bradport02/RX8-CANbusGateway/PCBs/RX8-7/RX8-7_BOM.xlsx

Reference | Qnty | Value | Component name | Vendor | Link | Cost per item | Required | Total
C100 | 1 | 10u | AEH0608100M050R | Mouser | Mouser (https://www.mouser.co.uk/ProductDetail/KYOCERA-AVX/AEH0608100M050R?qs=MyNHzdoqoQI9jDRNumUOww%3D%3D) | 0.39 | Y | 0.39
C101,C102,C103,C110,C111,C112,C118,C120,C130,C208,C209,C211,C212,C213,C225,C227,C309,C310,C311,C312,C313,C407,C411,C500,C501,C502,C506,C509,C510,C511,C512,C515,C516,C517,C519,C600,C602,C604,C605,C606,C703,C704,C705,C706,C707,C708 | 46 | 100n | 06035C104K4T2A | Mouser | Mouser (https://www.mouser.co.uk/ProductDetail/KYOCERA-AVX/06035C104K4T2A?qs=46Fswce4YXm2eEM3XUkmsQ%3D%3D) | 0.024 | Y | 1.104
C104,C117,C121,C124,C405,C408 | 6 | 10u | EEE-HC1C100R | Mouser | Mouser (https://www.mouser.co.uk/ProductDetail/Panasonic/EEE-HC1C100R?qs=Ywefl8B65e5dk7Zi6ZTZRw%3D%3D) | 0.285 | Y | 1.71
C105 | 1 | 220u | EDT227M035A9PAA | Mouser | Mouser (https://www.mouser.co.uk/ProductDetail/KEMET/EDT227M035A9PAA?qs=E9QF1UCAUX4pNM%252BmAGR2%252Bg%3D%3D) | 0.458 | Y | 0.458
C106, C127 | 2 | 1u | RSVVS010M1UBC3001U | Mouser | Mouser (https://www.mouser.co.uk/ProductDetail/Elna/RSVVS010M1UBC3001U?qs=4ASt3YYao0XVkuo7v80YiA%3D%3D) | 0.292 | Y | 0.584
C108,C109,C503,C518,C107,C115, C406 | 7 | 10u | 0603DD106MAT2A | Mouser | Mouser (https://www.mouser.co.uk/ProductDetail/KYOCERA-AVX/0603DD106MAT2A?qs=tlsG%2FOw5FFj9d7E8womxdg%3D%3D) | 0.223 | Y | 1.561
C113 | 1 | 22n | C0603C223J1RECAUTO | Mouser | Mouser (https://www.mouser.co.uk/ProductDetail/KEMET/C0603C223J1RECAUTO) | 0.165 | Y | 0.165
C114 | 1 | 100u | EDT107M050A9PAA | Mouser | Mouser (https://www.mouser.co.uk/ProductDetail/KEMET/EDT107M050A9PAA?qs=E9QF1UCAUX41fhlT8nGb9A%3D%3D) | 0.736 | Y | 0.736
C116,C223 | 2 | 47u | EEE-TG1V470UP | Mouser | Mouser (https://www.mouser.co.uk/ProductDetail/Panasonic/EEE-TG1V470UP?qs=aAAGLDy8P2zoL3Y76F8z7Q%3D%3D) | 0.713 | Y | 1.426
C119 | 1 | 4u7 | MBASE168BB5475KTNA18 | Mouser | Mouser (https://www.mouser.co.uk/ProductDetail/TAIYO-YUDEN/MBASE168BB5475KTNA18) | 0.285 | Y | 0.285
C122,C123 | 2 | 47u | GRM188R60J476ME01J | Mouser | Mouser (https://www.mouser.co.uk/ProductDetail/Murata-Electronics/GRM188R60J476ME01J?qs=pUKx8fyJudCHNFLdg5iCYA%3D%3D) | 0.361 | Y | 0.722
C125, C126 | 2 | 22u | GRM188D70J226ME01D | Mouser | Mouser (https://www.mouser.co.uk/ProductDetail/Murata-Electronics/GRM188D70J226ME01D) | 0.248 | Y | 0.496
C128 | 1 | 470u | EEE-FN1C471L | Mouser | Mouser (https://www.mouser.co.uk/ProductDetail/Panasonic/EEE-FN1C471L?qs=vmHwEFxEFR8QsHsuXLyd8Q%3D%3D) | 0.668 | Y | 0.668
C129,C300,C301,C302,C314 | 5 | 4u7 | EDH475M035A9BAA | Mouser | Mouser (https://www.mouser.co.uk/ProductDetail/KEMET/EDH475M035A9BAA?qs=E9QF1UCAUX6vP1%252BGIzmYew%3D%3D) | 0.24 | Y | 1.2
C200,C201,C202,C203,C204,C205,C206,C207,C214,C220,C221,C601,C603 | 13 | 1u | C0805C105M4RACAUTO | Mouser | Mouser (https://www.mouser.co.uk/ProductDetail/KEMET/C0805C105M4RACAUTO?qs=zDkSFN9STR%2FQblumrygq6Q%3D%3D) | 0.094 | Y | 1.222
C210,C226 | 2 | 470n | C0603C474K4PACTM | Mouser | Mouser (https://www.mouser.co.uk/ProductDetail/KEMET/C0603C474K4PACTM) | 0.12 | Y | 0.24
C215,C216,C217,C218,C409,C410,C412,C413,C507,C508 | 10 | 2u2 | MCASL21GSB7225KTNA1J | Mouser | Mouser (https://www.mouser.co.uk/ProductDetail/TAIYO-YUDEN/MCASL21GSB7225KTNA1J?qs=tlsG%2FOw5FFguOmt6f5zPzQ%3D%3D) | 0.084 | Y | 0.84
C219,C607 | 2 | 10u | KGM21AR51C106MU | Mouser | Mouser (https://www.mouser.co.uk/ProductDetail/KYOCERA-AVX/KGM21AR51C106MU?qs=9vOqFld9vZXNtlZ6Q186bg%3D%3D) | 0.368 | Y | 0.736
C222 | 1 | 4700u | EEE-FK1E472SM | Mouser | Mouser (https://www.mouser.co.uk/ProductDetail/Panasonic/EEE-FK1E472SM?qs=BZBei1rCqCCdye13ZQ7qPQ%3D%3D) | 2.71 | Y | 2.71
C303,C304,C305,C306,C307,C308,C315,C316 | 8 | 220u | EEE-FT1C221AL | Mouser | Mouser (https://www.mouser.co.uk/ProductDetail/Panasonic/EEE-FT1C221AL?qs=vmHwEFxEFR9Pfq5G0xjCHw%3D%3D) | 0.48 | Y | 3.84
C400,C401,C701,C702 | 4 | 22p | 06033A220DAT2A | Mouser | Mouser (https://www.mouser.co.uk/ProductDetail/KYOCERA-AVX/06033A220DAT2A) | 0.278 | Y | 1.112
C402,C403,L400 | 3 | NA |  |  |  |  | Y | 0
C404 | 1 | 470p | 06033A220DAT2A | Mouser | Mouser (https://www.mouser.co.uk/ProductDetail/KYOCERA-AVX/06033A220DAT2A) | 0.278 | Y | 0.278
C504,C505 | 2 | 12p | VJ0603D120JXPAJ | Mouser | Mouser (https://www.mouser.co.uk/ProductDetail/Vishay-Vitramon/VJ0603D120JXPAJ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) | 0.255 | Y | 0.51
C513,C514 | 2 | 15p | 06035U150FAT2A | Mouser | Mouser (https://www.mouser.co.uk/ProductDetail/KYOCERA-AVX/06035U150FAT2A) | 0.338 | Y | 0.676
D100, D102 | 3 | RF05VYM1SFHTR | RF05VYM1SFHTR | Mouser | Mouser (https://www.mouser.co.uk/ProductDetail/ROHM-Semiconductor/RF05VYM1SFHTR?qs=4v%252BiZTmLVHEBI5apodawUw%3D%3D) | 0.225 | Y | 0.675
D101,D500 | 2 | SMAJ24A | SMAJ24A | Mouser | Mouser (https://www.mouser.co.uk/ProductDetail/Bourns/SMAJ24A?qs=A3H9pljuJ8RK3%2FFerHGtzA%3D%3D) | 0.165 | Y | 0.33
D103,D104,D105 | 3 | Zener_15V | 1PGSMA4744H | Mouser | Mouser (https://www.mouser.co.uk/ProductDetail/Taiwan-Semiconductor/1PGSMA4744H?qs=lc2O%252BfHJPVY6dYy4zPUhBQ%3D%3D) | 0.361 | Y | 1.083
D107,D108,D110,D111,D112,D114,D115,D200,D400,D504,D604 | 11 | LED | 599-1010-147F | Mouser | Mouser (https://www.mouser.co.uk/ProductDetail/Dialight/599-1010-147F?qs=3GbUB62Nf7eZvIrTUxTNgA%3D%3D) | 0.127 | Y | 1.397
D109 | 1 | 1.5KExxA | SA36CA-E3/54 | Mouser | Mouser (https://www.mouser.co.uk/ProductDetail/Vishay-General-Semiconductor/SA36CA-E3-54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) | 0.413 | Y | 0.413
D401 | 1 | NUP2105L | NUP2105L | Mouser | Mouser (https://www.mouser.co.uk/ProductDetail/Diotec-Semiconductor/NUP2105L?qs=OlC7AqGiEDnwfsnn7%252BuLZg%3D%3D) | 0.271 | Y | 0.271
D501 | 1 | BAT54W | BAT54W | Mouser | Mouser (https://www.mouser.co.uk/ProductDetail/Diotec-Semiconductor/BAT54W?qs=OlC7AqGiEDlMBXEhja5nBg%3D%3D) | 0.135 | Y | 0.135
D502,D503,D600,D601,D602 | 5 | ESD9B5.0ST5G | ESD9B5.0ST5G | Mouser | Mouser (https://www.mouser.co.uk/ProductDetail/onsemi/ESD9B5.0ST5G?qs=HL4IEvuNMQqfrGPZiLZXfQ%3D%3D) | 0.075 | Y | 0.375
D505 | 1 | SS14 | SS14 | Mouser | Mouser (https://www.mouser.co.uk/ProductDetail/Taiwan-Semiconductor/SS14?qs=JV7lzlMm3yLIdi0ESVd3YQ%3D%3D) | 0.173 | Y | 0.173
D603 | 1 | WS2812B | WS2812B | Mouser | Mouser | 0.6 | Y | 0.6
D700,D701 | 2 | ESD2CAN24DBZRQ1 | ESD2CAN24DBZRQ1 | Mouser | Mouser (https://www.mouser.co.uk/ProductDetail/Texas-Instruments/ESD2CAN24DBZRQ1?qs=Y0Uzf4wQF3knJz9mU6BNuw%3D%3D) | 0.54 | Y | 1.08
FB100 | 1 | FerriteBead | ABPY00160808121Y00 | Mouser | Mouser (https://www.mouser.co.uk/ProductDetail/Pulse-Electronics/ABPY00160808121Y00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) | 0.083 | Y | 0.083
FB400 | 1 | FerriteBead | NA |  |  | 0 | Y | 0
FB500 | 1 | FerriteBead | BLM18RK102SN1D | Mouser | Mouser (https://www.mouser.co.uk/ProductDetail/Murata-Electronics/BLM18RK102SN1D?qs=%252BZb2rAcz85rrD89adt6lAQ%3D%3D) | 0.075 | Y | 0.075
J100,J502,J601 | 3 | USB_C_Receptacle_USB2.0_16P | UJ20-C-H-G-SMT-2A-P16-TR | Mouser | Mouser (https://www.mouser.co.uk/ProductDetail/Same-Sky/UJ20-C-H-G-SMT-2A-P16-TR?qs=6avfeC6zeS4lRZlgHZHlwQ%3D%3D) | 0.361 | Y | 1.083
J401 | 1 | Audio Jack | 35RASMT6CHNTRX | Mouser | Mouser (https://www.mouser.co.uk/ProductDetail/Switchcraft/35RASMT6CHNTRX?qs=tlsG%2FOw5FFjAOUhC8CJiRQ%3D%3D) | 1.86 | Y | 1.86
J600 | 1 | Conn_01x28_Pin | PHDR-28VS | Mouser | Mouser (https://www.mouser.co.uk/ProductDetail/JST-Commercial/PHDR-28VS?qs=QpmGXVUTftGCZ07TNYaQpw%3D%3D) | 0.353 | Y | 0.353
J800 | 1 | 34958-0383 | 34958-0383 | Mouser | Mouser (https://www.mouser.co.uk/ProductDetail/Molex/34958-0383?qs=Zz7%252BYVVL6bGxJEg%252BS51b4A%3D%3D) | 1.98 | Y | 1.98
J800 [MALE] | 1 | 34959-0390 | 34959-0390 | Mouser | Mouser (https://www.mouser.co.uk/ProductDetail/Molex/34959-0390?qs=Zz7%252BYVVL6bFXGwaF6xpqsw%3D%3D) | 1.9 | Y | 1.9
J802 | 1 | Fakra | 2FA1-NCSP-PCBB6 | Mouser | Mouser (https://www.mouser.co.uk/ProductDetail/Amphenol-RF/2FA1-NCSP-PCBB6?qs=hWgE7mdIu5RJuEY7QFoJaQ%3D%3D) | 2.43 | Y | 2.43
L100 | 1 | 4.7uH | XAL7030-472MEC | Mouser | Mouser (https://www.mouser.co.uk/ProductDetail/Coilcraft/XAL7030-472MEC?qs=zCSbvcPd3paDmbzDaM4bvA%3D%3D) | 1.9 | Y | 1.9
L200,L201,L202,L203 | 4 | 10u | SRP5030HMT-100M | Mouser | Mouser (https://www.mouser.co.uk/ProductDetail/Bourns/SRP5030HMT-100M?qs=Tc%252BHE9vUsntweIXd4XNonQ%3D%3D) | 0.89 | N | 0
L401 | 1 | 10u | NLCV32T-100J-EFRD | Mouser | Mouser (https://www.mouser.co.uk/ProductDetail/TDK/NLCV32T-100J-EFRD?qs=6avfeC6zeS43g1Pl%252BxWcqA%3D%3D) | 0.21 | Y | 0.21
Q100,Q300,Q301,Q400,Q401,Q402,Q403,Q404,Q500,Q501,Q502,Q503,Q600,Q601,Q602 | 15 | NPN | BC817 | Mouser | Mouser (https://www.mouser.co.uk/ProductDetail/Rectron/BC817?qs=7pEAo90IqNG%2FF7QnbDH5iA%3D%3D) | 0.249 | Y | 3.735
Q101,Q102,Q103 | 3 | P-Channel Mosfet | SQJ407EP-T1_GE3 | Mouser | Mouser (https://www.mouser.co.uk/ProductDetail/Vishay-Semiconductors/SQJ407EP-T1_GE3?qs=5aG0NVq1C4xX2SBP0n1NTg%3D%3D) | 1.43 | Y | 4.29
R100,R110,R113,R205,R416,R518,R615,R109,R114,R123 | 10 | 22k | CRG0603F22K/10 | Mouser | Mouser (https://www.mouser.co.uk/ProductDetail/TE-Connectivity-Holsworthy/CRG0603F22K-10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) | 0.015 | Y | 0.15
R101,R102,R206,R207,R208,R209,R210,R211,R213,R360,R361,R400,R401,R402,R403,R404,R405,R408,R409,R413,R414,R417,R418,R419,R420,R500,R501,R502,R504,R506,R509,R510,R511,R516,R600,R601,R609,R610,R614,R702,R707,R709,R340,R341,R342,R343,R344,R345,R364,R365,R708 | 51 | 10k | 0603WAJ0103TCE | Mouser | Mouser (https://www.mouser.co.uk/ProductDetail/Royalohm/0603WAJ0103TCE) | 0.005 | Y | 0.255
R103,R104 | 2 | 2k5 | RNCF0603BTE2K50 | Mouser | Mouser (https://www.mouser.co.uk/ProductDetail/SEI-Stackpole/RNCF0603BTE2K50) | 0.075 | Y | 0.15
R105,R106 | 2 | 10k | RMCF1210JT180R | Mouser | Mouser (https://www.mouser.co.uk/ProductDetail/SEI-Stackpole/RMCF1210JT180R?qs=IPgv5n7u5QaiAbC7MQ%252BkTQ%3D%3D) | 0.09 | Y | 0.18
R107,R108,R505,R508,R604,R605 | 10 | 5k1 | AC0603FR-7W5K1L | Mouser | Mouser (https://www.mouser.co.uk/ProductDetail/YAGEO/AC0603FR-7W5K1L) | 0.019 | Y | 0.19
R111 | 1 | 62k | CR0603-JW-623ELF | Mouser | Mouser (https://www.mouser.co.uk/ProductDetail/Bourns/CR0603-JW-623ELF) | 0.075 | Y | 0.075
R112 | 1 | 51k | CR0603-JW-513ELF | Mouser | Mouser (https://www.mouser.co.uk/ProductDetail/Bourns/CR0603-JW-513ELF?qs=tknLyCMIRbODFBOq4KB%2Fuw%3D%3D) | 0.075 | Y | 0.075
R115,R204 | 2 | 100k | CR0603-JW-104ELF | Mouser | Mouser (https://www.mouser.co.uk/ProductDetail/Bourns/CR0603-JW-104ELF?qs=wOX%252BDVkMoZSK2gq9cFrtRg%3D%3D) | 0.075 | Y | 0.15
R116 | 1 | 240R | CR0603-FX-2400ELF | Mouser | Mouser (https://www.mouser.co.uk/ProductDetail/Bourns/CR0603-FX-2400ELF?qs=I4suiNu8FYBRQqwAwbm7zw%3D%3D) | 0.075 | Y | 0.075
R117 | 1 | 1k5 | CR0603-JW-152ELF | Mouser | Mouser (https://www.mouser.co.uk/ProductDetail/Bourns/CR0603-JW-152ELF?qs=wOX%252BDVkMoZSu%252BfxzrcTI6Q%3D%3D) | 0.075 | Y | 0.075
R118,R122 | 2 | 2K2 | CR0603-FX-2201ELF | Mouser | Mouser (https://www.mouser.co.uk/ProductDetail/Bourns/CR0603-FX-2201ELF?qs=zx2075yZkZKUzLkJq4yLqg%3D%3D) | 0.075 | Y | 0.15
R119 | 1 | 2k | CR0603-JW-202ELF | Mouser | Mouser (https://www.mouser.co.uk/ProductDetail/Bourns/CR0603-JW-202ELF?qs=QNvGIbmBFedJvqrSZNeMIw%3D%3D) | 0.075 | Y | 0.075
R120 | 1 | 12k | CR0603-FX-1202ELF | Mouser | Mouser (https://www.mouser.co.uk/ProductDetail/Bourns/CR0603-FX-1202ELF?qs=e7cxVwPieuqIXTNAyS26aw%3D%3D) | 0.075 | Y | 0.075
R121 | 1 | 1k8 | CR0603-FX-1801ELF | Mouser | Mouser (https://www.mouser.co.uk/ProductDetail/Bourns/CR0603-FX-1801ELF) | 0.075 | Y | 0.075
R200,R201,R202,R203 | 4 | 10R | RC0603JR-7W10RL | Mouser | Mouser (https://www.mouser.co.uk/ProductDetail/YAGEO/RC0603JR-7W10RL?qs=qpJ%252B%252B%252Bdg6p3Vm%252BWSNdcdfQ%3D%3D) | 0.075 | Y | 0.3
R212,R603 | 2 | 47k | CR0603-FX-4702ELF | Mouser | Mouser (https://www.mouser.co.uk/ProductDetail/Bourns/CR0603-FX-4702ELF?qs=CCIlxZRRv7h9SmHwXOyFMw%3D%3D) | 0.075 | Y | 0.15
R300,R301,R302,R348 | 4 | 4k3 | CR0603-JW-432ELF | Mouser | Mouser (https://www.mouser.co.uk/ProductDetail/Bourns/CR0603-JW-432ELF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) | 0.075 | Y | 0.3
R303,R304,R305,R313,R315,R321,R334,R335,R336,R337,R338,R339,R349,R353,R362,R363,R317,R318,R319,R320,R507,R520,R606,R607,R611,R612,R700,R703,R704 | 29 | 0R | CR0603AJ/-000EAS | Mouser | Mouser (https://www.mouser.co.uk/ProductDetail/Bourns/CR0603AJ-000EAS?qs=PzGy0jfpSMtRj%252B7fJP4d3A%3D%3D) | 0.013 | Y | 0.377
R306,R307,R310,R350 | 4 | 27k | CR0603-FX-2702ELF | Mouser | Mouser (https://www.mouser.co.uk/ProductDetail/Bourns/CR0603-FX-2702ELF?qs=I4suiNu8FYAlO3noFFocQg%3D%3D) | 0.075 | Y | 0.3
R308,R309,R311,R312,R314,R316,R331,R332,R333,R351,R352,R359 | 12 | 4k7 | AC0603JR-104K7L | Mouser | Mouser (https://www.mouser.co.uk/ProductDetail/YAGEO/AC0603JR-104K7L?qs=r5DSvlrkXmI4EipxgBaQVg%3D%3D) | 0.011 | Y | 0.132
R322,R323,R324,R328,R329,R330,R357,R358 | 8 | 4R7 | CRCW06034R70FKEAC | Mouser | Mouser (https://www.mouser.co.uk/ProductDetail/Vishay/CRCW06034R70FKEAC) | 0.027 | Y | 0.216
R325,R326,R327,R354. R355,R356,R406,R407,R410,R411,R412,R503,R514,R517,R608,R613 | 16 | 1k | CR0603-FX-1001EPF | Mouser | Mouser (https://www.mouser.co.uk/ProductDetail/Bourns/CR0603-FX-1001EPF) | 0.028 | Y | 0.448
R346,R347 | 2 | 3k3 | CR0603-FX-3301ELF | Mouser | Mouser (https://www.mouser.co.uk/ProductDetail/Bourns/CR0603-FX-3301ELF?qs=I4suiNu8FYAeN75YxKNWXA%3D%3D) | 0.075 | Y | 0.15
R421,R422 | 2 | 470R | RC0603FR-07470RL | Mouser | Mouser (https://www.mouser.co.uk/ProductDetail/YAGEO/RC0603FR-07470RL) | 0.075 | Y | 0.15
R512,R513 | 2 | 22R | RC0603JR-0722RL | Mouser | Mouser (https://www.mouser.co.uk/ProductDetail/YAGEO/RC0603JR-0722RL) | 0.075 | Y | 0.15
R515 | 1 | 82k | 560112116085 | Mouser | Mouser (https://www.mouser.co.uk/ProductDetail/Wurth-Elektronik/560112116085) | 0.083 | Y | 0.083
R519 | 1 | 33k | RC0603DR-0733KL | Mouser | Mouser (https://www.mouser.co.uk/ProductDetail/YAGEO/RC0603DR-0733KL) | 0.075 | Y | 0.075
R602 | 1 | 22k1 | CR0603-FX-2212ELF | Mouser | Mouser (https://www.mouser.co.uk/ProductDetail/Bourns/CR0603-FX-2212ELF) | 0.075 | Y | 0.075
R701,R705,R706 | 3 | 120R | CR0603-JW-121ELF | Mouser | Mouser (https://www.mouser.co.uk/ProductDetail/Bourns/CR0603-JW-121ELF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) | 0.075 | Y | 0.225
REG100 | 1 | TPS7B8233QDGNRQ1 | TPS7B8233QDGNRQ1 | Mouser | Mouser (https://www.mouser.co.uk/ProductDetail/Texas-Instruments/TPS7B8233QDGNRQ1?qs=gTYE2QTfZfTgserf%2FHg6KA%3D%3D) | 1.35 | Y | 1.35
REG101 | 1 | LF80_TO252 | LF80CDT-TR | Mouser | Mouser (https://www.mouser.co.uk/ProductDetail/STMicroelectronics/LF80ABDT-TR?qs=rQxjsk9FJaKqWqynhzWMLQ%3D%3D) | 0.801 | Y | 0.801
REG102 | 1 | LD1117S33TR_SOT223 | LD1117S33TR | Mouser | Mouser (https://www.mouser.co.uk/ProductDetail/STMicroelectronics/LD1117S33TR?qs=edoyzKMbmhntQZx4BFmoqw%3D%3D) | 0.255 | Y | 0.255
REG103 | 1 | MPQ4317GRE-5-AEC1-P | MPQ4317GRE-5-AEC1-P | Mouser | Mouser (https://www.mouser.co.uk/ProductDetail/Monolithic-Power-Systems-MPS/MPQ4317GRE-5-AEC1-P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) | 4.33 | Y | 4.33
REG104 | 1 | NCV1117DT33T5G | NCV1117DT33T5G | Mouser | Mouser (https://www.mouser.co.uk/ProductDetail/onsemi/NCV1117DT33T5G?qs=8sOby8ZxZLGSqIbW45S1Hw%3D%3D) | 0.45 | Y | 0.45
REG105 | 1 | NCV317MBDTRKG | NCV317MBDTRKG | Mouser | Mouser (https://www.mouser.co.uk/ProductDetail/onsemi/NCV317MBDTRKG?qs=u61i7LeC7JdMf7rjvmy4qA%3D%3D) | 0.323 | Y | 0.323
REG106 | 1 | LDO40LPURY | LDO40LPURY | Mouser | Mouser (https://www.mouser.co.uk/ProductDetail/STMicroelectronics/LDO40LPURY?qs=qSfuJ%252Bfl%2Fd6C3Fwu6g7H1A%3D%3D) | 1.89 | Y | 1.89
RN600 | 1 | R_Network04 | EXB-24V103JX | Mouser | Mouser (https://www.mouser.co.uk/ProductDetail/Panasonic/EXB-24V103JX?qs=oE3VwAv%2FYtkgg9h0ON1hVg%3D%3D) | 0.075 | Y | 0.075
SW500,SW600,SW601 | 3 | PTS636SKG25JSMTR_LFS | PTS636SKG25JSMTR LFS | Mouser | Mouser (https://www.mouser.co.uk/ProductDetail/CK/PTS636SKG25JSMTR-LFS?qs=jcD%2FCkGBYeNo6fuer6a%2Fog%3D%3D) | 0.18 | Y | 0.54
U200 | 1 | TDA7719 | TDA7719 | Mouser | Mouser (https://www.mouser.co.uk/ProductDetail/STMicroelectronics/TDA7719?qs=pW7VN3fQ%252BU8DQGKC11TzWg%3D%3D) | 2.7 | Y | 2.7
U201 | 1 | TDA7388 | TDA7388 | Mouser | Mouser (https://www.mouser.co.uk/ProductDetail/STMicroelectronics/TDA7388?qs=zDsuRuHENM8sRq8DuFBdHA%3D%3D) | 2.97 | Y | 2.97
U300,U301,U302,U303 | 4 | NJM4556A | NJM4556AM | Mouser | Mouser (https://www.mouser.co.uk/ProductDetail/Nisshinbo/NJM4556AM?qs=Dx6nUK05NTEu0NN353RDQw%3D%3D) | 0.736 | N | 0
U400 | 1 | SI4703-C19-GM | SI4703-C19-GM | Mouser | Mouser (https://www.mouser.co.uk/ProductDetail/Skyworks-Solutions-Inc/SI4703-C19-GM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) | 2.6 | Y | 2.6
U401 | 1 | PCM5102A | PCM5102APWR | Mouser | Mouser (https://www.mouser.co.uk/ProductDetail/Texas-Instruments/PCM5102APWR?qs=E2%2FxqS9xjzrfECkwEYoiyg%3D%3D) | 2.96 | Y | 2.96
U500 | 1 | MCP1402T-E_OT | MCP1402T-E/OT | Mouser | Mouser (https://www.mouser.co.uk/ProductDetail/Microchip-Technology/MCP1402T-E-OT?qs=aE5D7Pt6ky3dpBpieBLY3A%3D%3D) | 0.563 | Y | 0.563
U501 | 1 | STM32H750VBTx | STM32H750VBT | Mouser | Mouser (https://www.mouser.co.uk/ProductDetail/STMicroelectronics/STM32H750VBT6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) | 5.56 | Y | 5.56
U502 | 1 | W25Q32JVSS | W25Q32JWSSIQ | Mouser | Mouser (https://www.mouser.co.uk/ProductDetail/Winbond/W25Q32JWSSIQ?qs=qSfuJ%252Bfl%2Fd7AWkQW3HAQ%252Bw%3D%3D) | 0.826 | Y | 0.826
U503 | 1 | 74HC245 | 74HC245D-Q100J | Mouser | Mouser (https://www.mouser.co.uk/ProductDetail/Nexperia/74HC245D-Q100J?qs=fi7yB2oewZl7Ar%2FomFTdgQ%3D%3D) | 0.45 | Y | 0.45
U600 | 1 | CP2102N-Axx-xQFN28 | CP2102N-A02-GQFN28R | Mouser | Mouser (https://www.mouser.co.uk/ProductDetail/Silicon-Labs/CP2102N-A02-GQFN28R?qs=u16ybLDytRag4qKvSH3fTw%3D%3D) | 2.65 | Y | 2.65
U601 | 1 | ESP32-S3-WROOM-1 | ESP32-S3-WROOM-1-N16R8 | Mouser | Mouser (https://www.mouser.co.uk/ProductDetail/Espressif-Systems/ESP32-S3-WROOM-1-N16R8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) | 5.04 | Y | 5.04
U602 | 1 | Raspberry_Pi_5 | Raspberry Pi 5 4GB | Farnell | Farnell (https://uk.farnell.com/raspberry-pi/rpi5-4gb-single/rpi-5-board-2-4ghz-4gb-arm-cortex/dp/4255998) | 75.552 | N | 0
U700,U702,U703 | 3 | TCAN1051VDRQ1 | TCAN1051VDRQ1 | Mouser | Mouser (https://www.mouser.co.uk/ProductDetail/Texas-Instruments/TCAN1051VDRQ1?qs=dSktwyqbRaUHuzLGCY%2FY8w%3D%3D) | 1.68 | Y | 5.04
U701 | 1 | MCP2515-xSO | MCP2515T-E/SO | Mouser | Mouser (https://www.mouser.co.uk/ProductDetail/Microchip-Technology/MCP2515T-E-SO?qs=YUl711QUJY3%2FLJ5ChGwQqA%3D%3D) | 2.23 | Y | 2.23
U704,U705 | 2 | LM75B | LM75BIMMX-5/NOPB | Mouser | Mouser (https://www.mouser.co.uk/ProductDetail/Texas-Instruments/LM75BIMMX-5-NOPB?qs=QbsRYf82W3E9QxE2qGaF1g%3D%3D) | 1.15 | Y | 2.3
X400,X501 | 2 | 32.768K | CM7V-T1A-32.768kHz-12.5pF-20PPM-TC-QA | Mouser | Mouser (https://www.mouser.co.uk/ProductDetail/Micro-Crystal/CM7V-T1A-32.768kHz-12.5pF-20PPM-TC-QA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) | 0.632 | Y | 1.264
X500 | 1 | 25MHz | LFXTAL071758Cutt | Mouser | Mouser (https://www.mouser.co.uk/ProductDetail/IQD/LFXTAL071758Cutt?qs=nFovR%252B4R4UN8RYPh9I588Q%3D%3D) | 0.533 | Y | 0.533
X700 | 1 | 8MHz | HC49SDLF-8.00MHz | Mouser | Mouser (https://www.mouser.co.uk/ProductDetail/Fox-Abracon/HC49SDLF-8.00MHz?qs=zaGjUjd0x6RJRj%2Fgg2Mq7A%3D%3D) | 0.196 | Y | 0.196
Component Count: | 405 |  |  |  |  |  | Total: | 102.877
