bradport02/RX8-CANbusGateway/PCBs/RX8-7/RX8-7.pdf

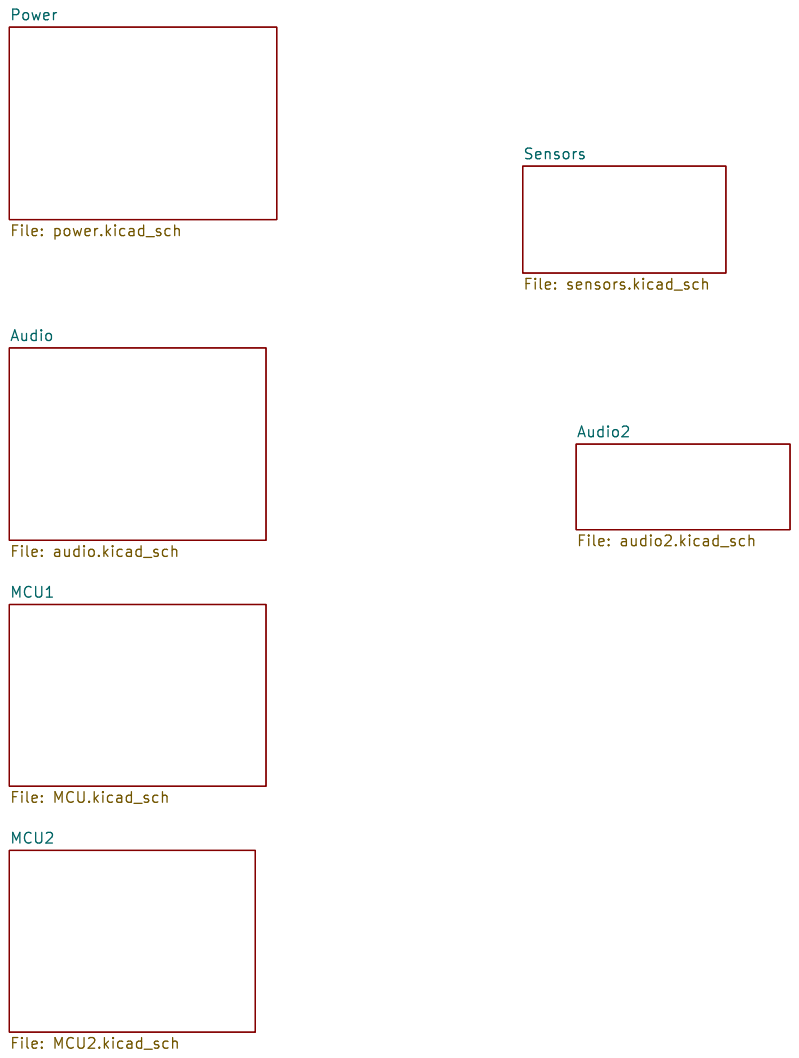
[picture p1: page 1]

Sensors File: sensors.kicad_sch MCU1 File: MCU.kicad_sch Audio File: audio.kicad_sch MCU2 File: MCU2.kicad_sch

Id: 1/7 Title: File: RX8-7.kicad_sch Sheet: /

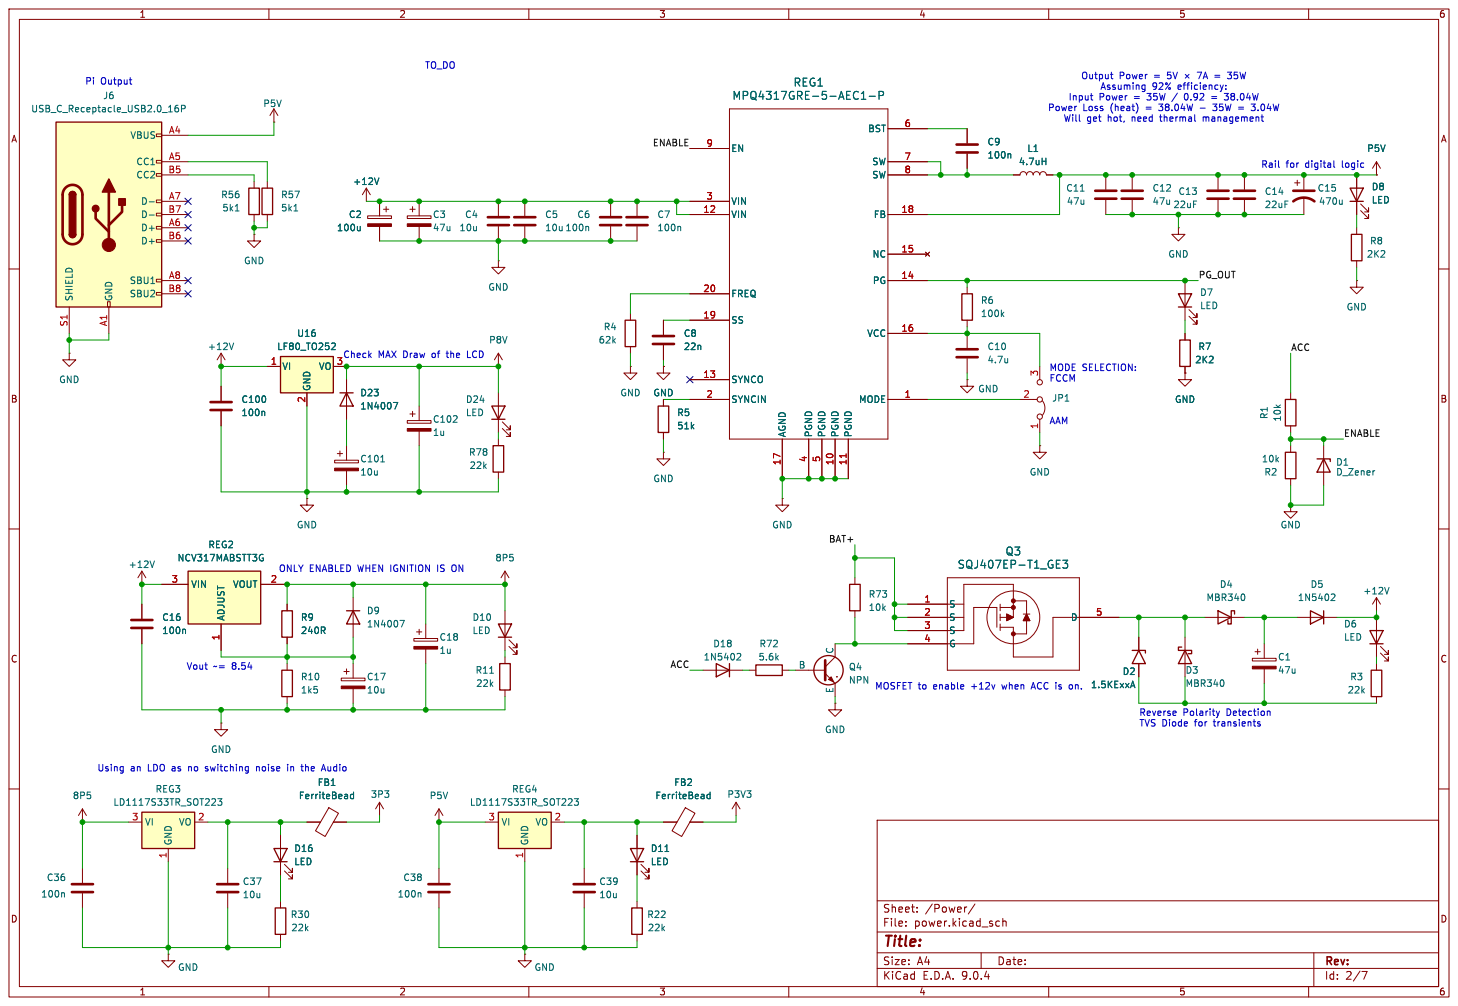
[picture p2: page 2]

5 PGND 10 PGND 11 BST 6 SW 7 SW 8 FB 18 NC 15 PG 14 VCC 16 MODE 1 REG1

5 PGND 10 PGND 11 BST 6 SW 7 SW 8 FB 18 NC 15 PG 14 VCC 16 MODE 1 GND
LED

Id: 2/7 Title: File: power.kicad_sch Sheet: /Power/

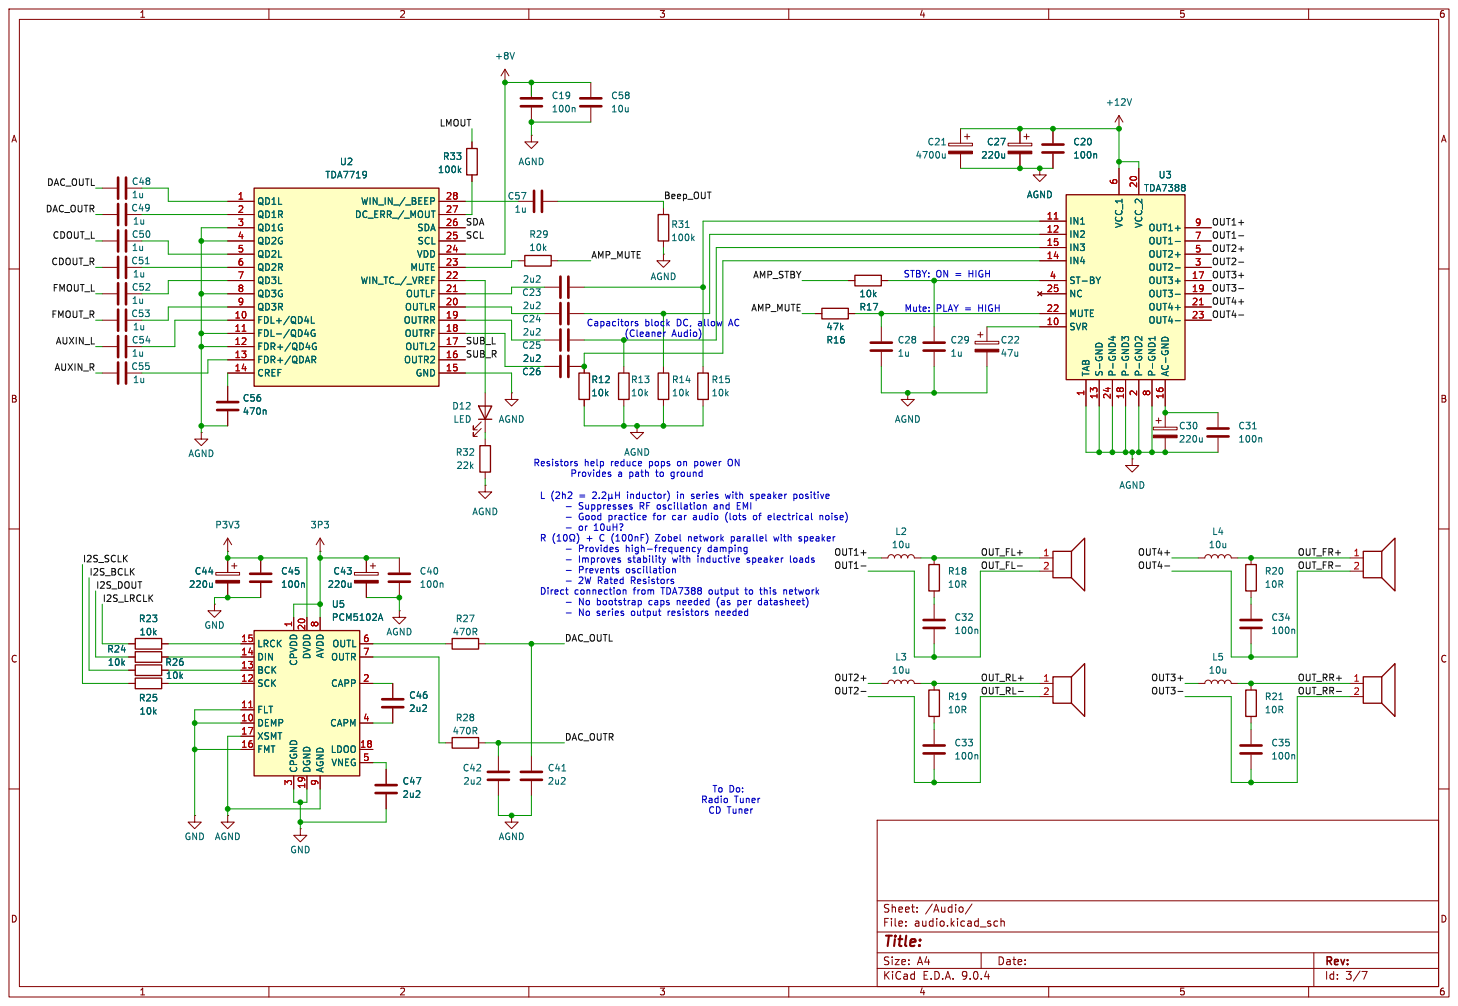
[picture p3: page 3]

8 AC-GND 16 OUT1+ 9 OUT1- 7 OUT2+ 5 OUT2- 3 OUT3+ 17 OUT3- 19 OUT4+ 21 OUT4- 23 U2 TDA7719 QD1L 1 QD1R 2 QD1G 3 QD2G 4 QD2L 5 QD2R 6 QD3L 7 QD3G 8 QD3R 9 FDL+/QD4L 10 FDL-/QD4G 11 FDR+/QD4G 12 FDR+/QDAR 13 CREF 14 WIN_IN_/_BEEP 28 DC_ERR_/_MOUT 27 SDA 26 SCL 25 VDD 24 MUTE 23 WIN_TC_/_VREF 22 OUTLF 21 OUTLR 20 OUTRR 19 OUTRF 18 OUTL2 17 OUTR2 16 GND 15 C56

9 OUTL 6 OUTR 7 CAPP 2 CAPM 4

Id: 3/7 Title: File: audio.kicad_sch Sheet: /Audio/

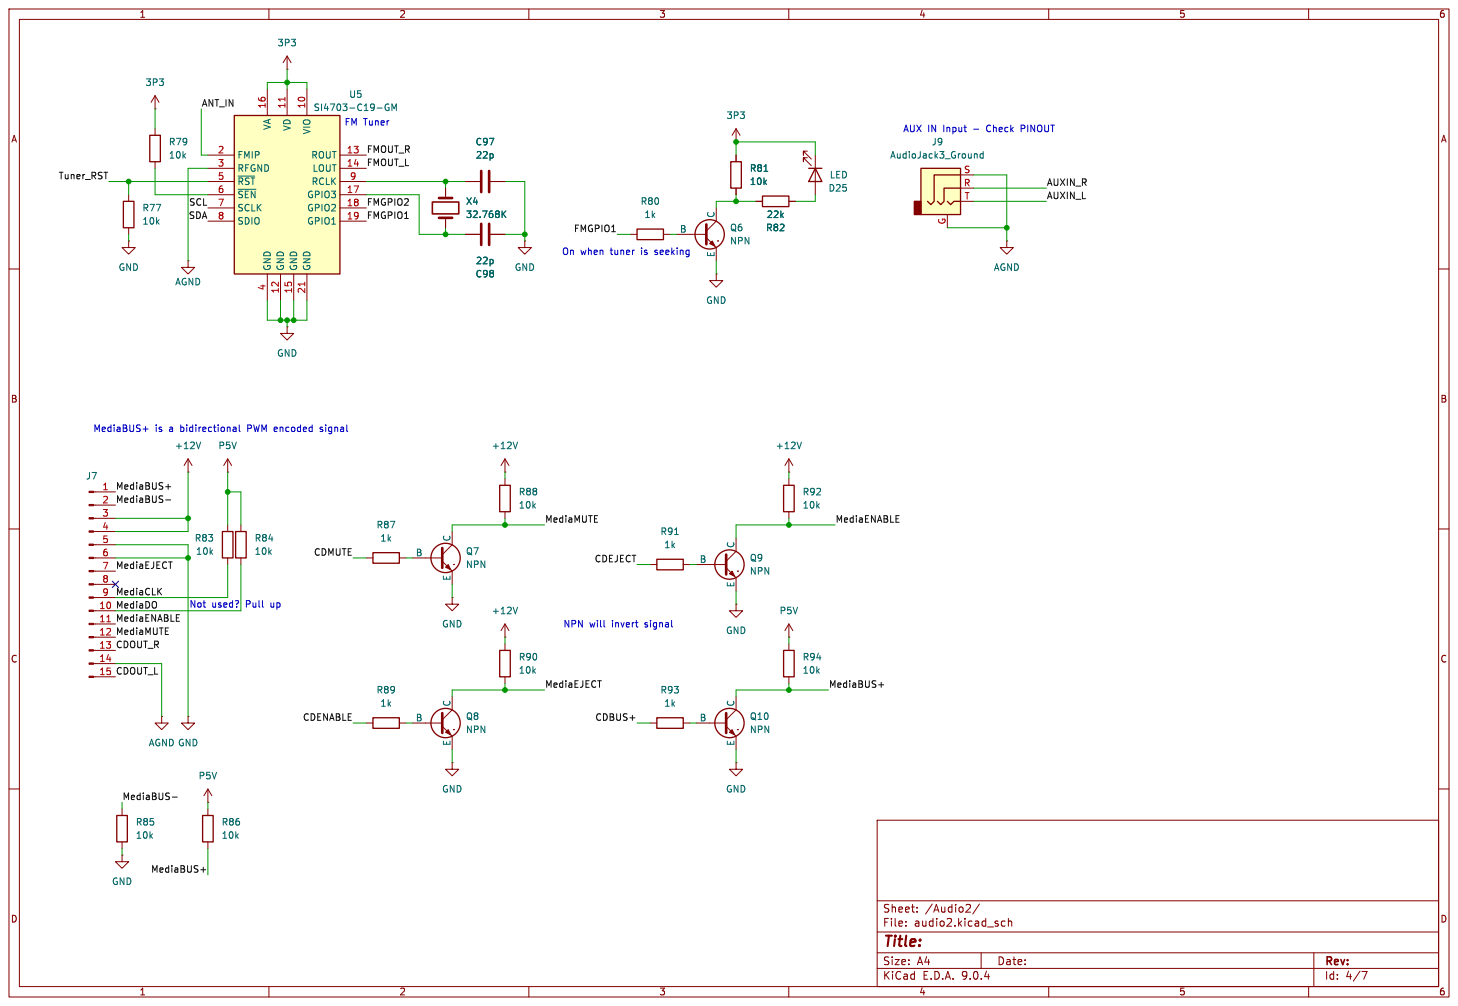
[picture p4: page 4]

4 GND 12 VD 11 GND 15 VIO 10 GND 21 ROUT 13

Id: 4/7 Title: File: audio2.kicad_sch Sheet: /Audio2/ R83

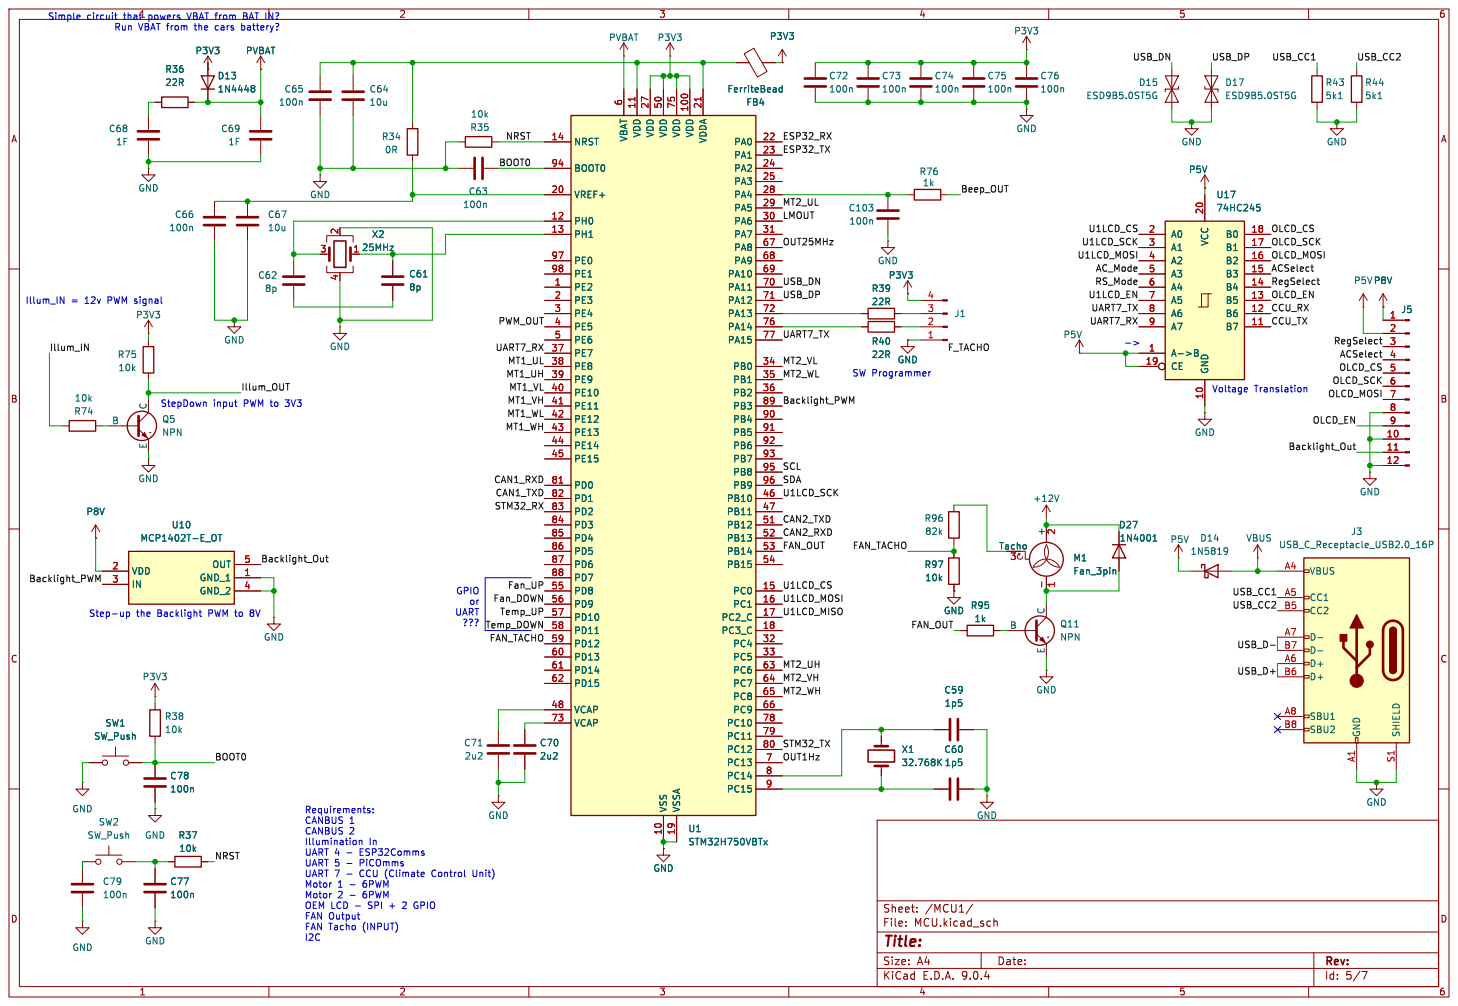
[picture p5: page 5]

6 VDD 11 VDD 27 VDD 50 VSS 10 VDD 75 VSSA 19 VDD 100 VDDA 21 PA0 22 PA1 23 PA2 24 PA3 25 PA4 28 PA5 29 PA6 30 PA7 31 PA8 67 PA9 68 PA10 69 PA11 70 PA12 71 PA13 72 PA14 76 PA15 77 PB0 34 PB1 35 PB2 36 PB3 89 PB4 90 PB5 91 PB6 92 PB7 93 PB8 95 PB9 96 PB10 46 PB11 47 PB12 51 PB13 52 PB14 53 PB15 54 PC0 15 PC1 16 PC2_C 17 PC3_C 18 PC4 32 PC5 33 PC6 63 PC7 64 PC8 65 PC9 66 PC10 78 PC11 79 PC12 80 PC13 7 PC14 8 PC15 9 U1STM32H750VBTx GND

6 VDD 11 VDD 27 VDD 50 VSS 10 VDD 75 VSSA 19 VDD 100 VDDA 21 PA0 22 PA1 23 PA2 24 PA3 25 PA4 28 PA5 29 PA6 30 PA7 31 PA8 67 PA9 68 PA10 69 PA11 70 PA12 71 PA13 72 PA14 76 PA15 77 PB0 34 PB1 35 PB2 36 PB3 89 PB4 90 PB5 91 PB6 92 PB7 93 PB8 95 PB9 96 PB10 46 PB11 47 PB12 51 PB13 52 PB14 53 PB15 54 PC0 15 PC1 16 PC2_C 17 PC3_C 18 PC4 32 PC5 33 PC6 63 PC7 64 PC8 65 PC9 66 PC10 78 PC11 79 PC12 80 PC13 7 PC14 8 PC15 9 GND

22R GND
Voltage Translation SW Programmer

Motor 2 - 6PWM
OEM LCD - SPI + 2 GPIO
FAN Output FAN Tacho (INPUT)

Id: 5/7 Title: File: MCU.kicad_sch Sheet: /MCU1/

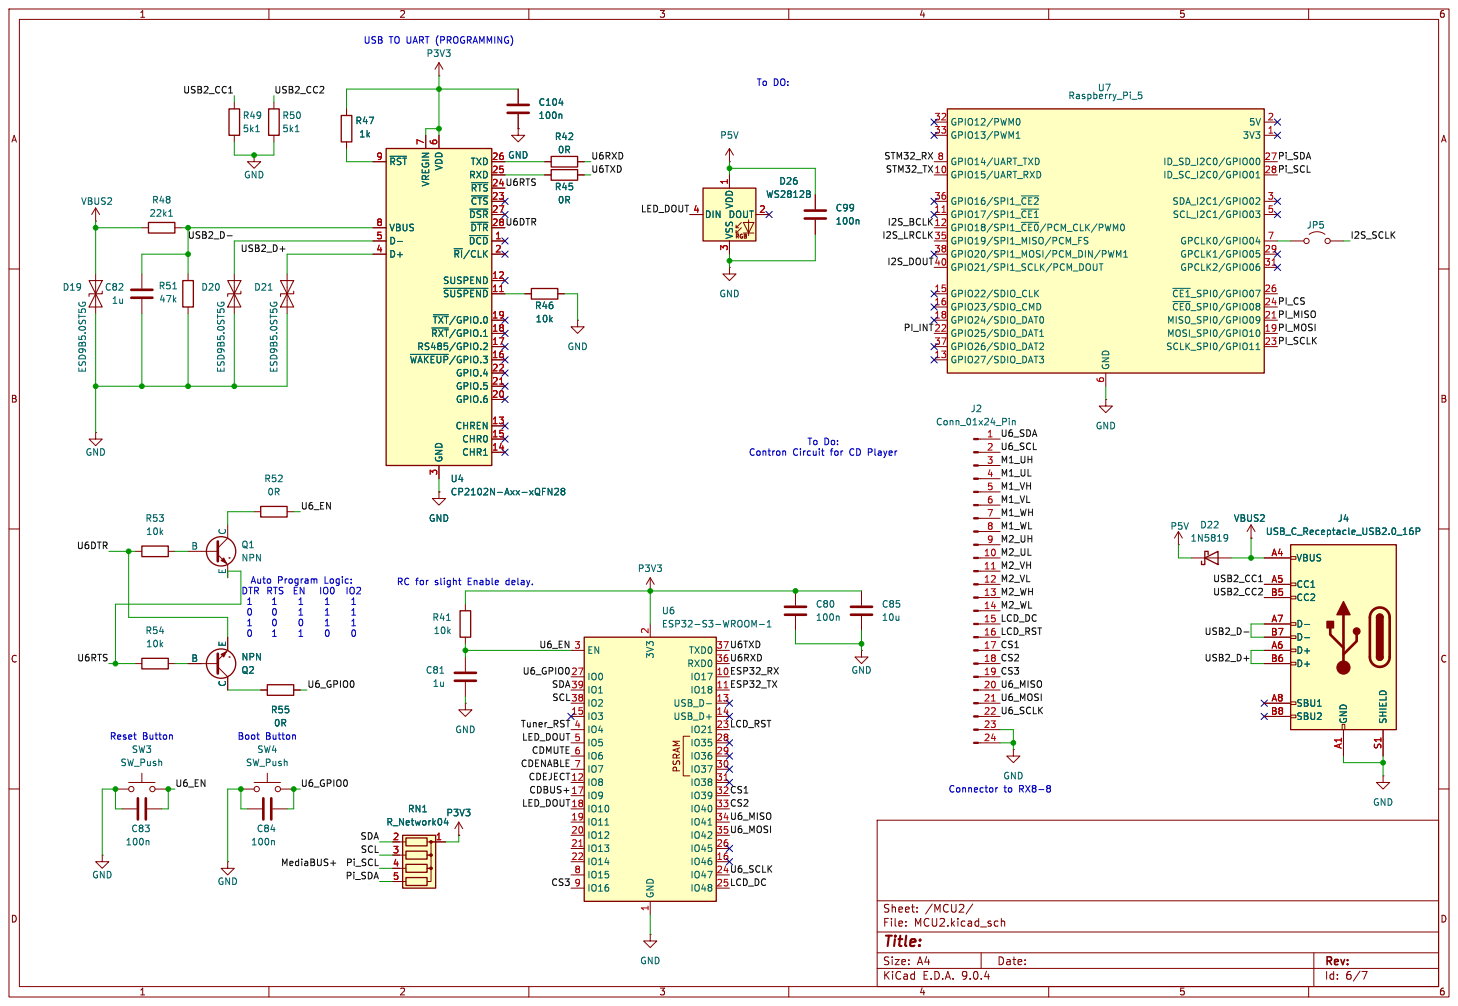
[picture p6: page 6]

3 TXD 26 RXD 25 ~{RTS} 24 ~{CTS} 23 ~{DSR} 27 ~{DTR} 28 ~{DCD}1 ~{RI}/CLK2 SUSPEND 12 ~{SUSPEND}11 ~{TXT}/GPIO.019 ~{RXT}/GPIO.118 RS485/GPIO.2 17 ~{WAKEUP}/GPIO.316 GPIO.4 22 GPIO.5 21 GPIO.6 20 CHREN 13 CHR0 15 CHR1 14 U4 CP2102N-Axx-xQFN28C104

3 TXD 26 RXD 25 ~{RTS} 24 ~{CTS} 23 ~{DSR} 27 ~{DTR} 28 ~{DCD}1 ~{RI}/CLK2 SUSPEND 12 ~{SUSPEND}11 ~{TXT}/GPIO.019 ~{RXT}/GPIO.118 RS485/GPIO.2 17 ~{WAKEUP}/GPIO.316 GPIO.4 22 GPIO.5 21 GPIO.6 20 CHREN 13 CHR0 15 CHR1 14 GND

LED_DOUT CDMUTE CDENABLE CDEJECT CDBUS+

Id: 6/7 Title: File: MCU2.kicad_sch Sheet: /MCU2/

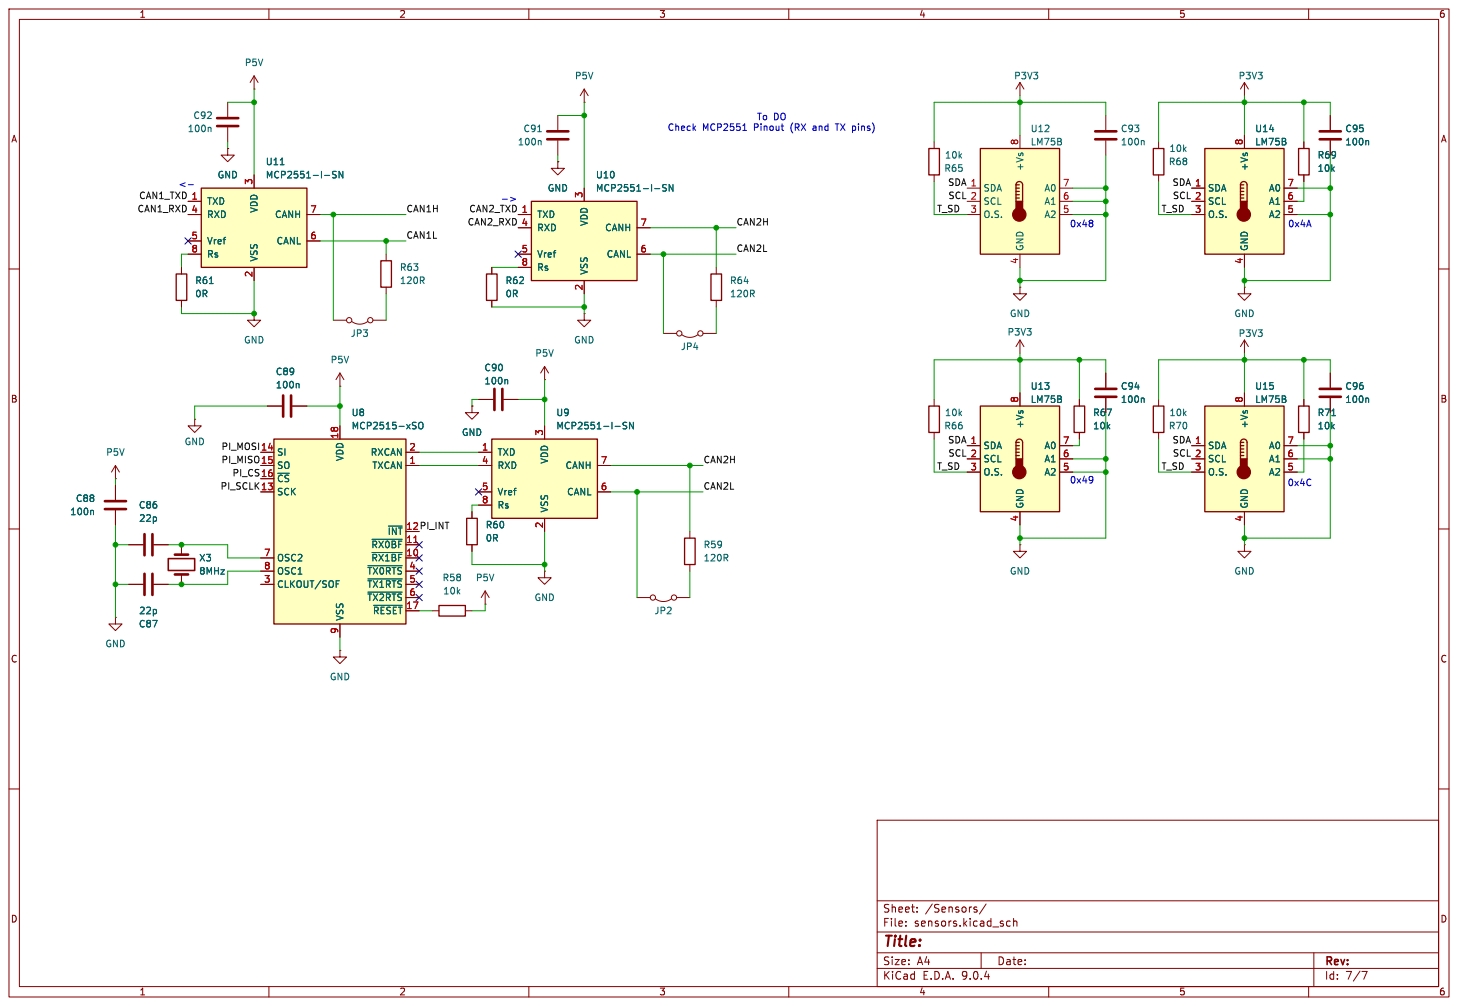
[picture p7: page 7]

9 RXCAN 2 TXCAN 1 ~{INT} 12 ~{RX0BF}11 ~{RX1BF}10 ~{TX0RTS}4 ~{TX1RTS}5 ~{TX2RTS}6 ~{RESET} 17 U8 MCP2515-xSO

9 RXCAN 2 TXCAN 1 ~{INT} 12 ~{RX0BF}11 ~{RX1BF}10 ~{TX0RTS}4 ~{TX1RTS}5 ~{TX2RTS}6 ~{RESET} 17 C88

Id: 7/7 Title: File: sensors.kicad_sch Sheet: /Sensors/
