bradport02/RX8-CANbusGateway/PCBs/RX8-7/RX8-7-Audio2.pdf

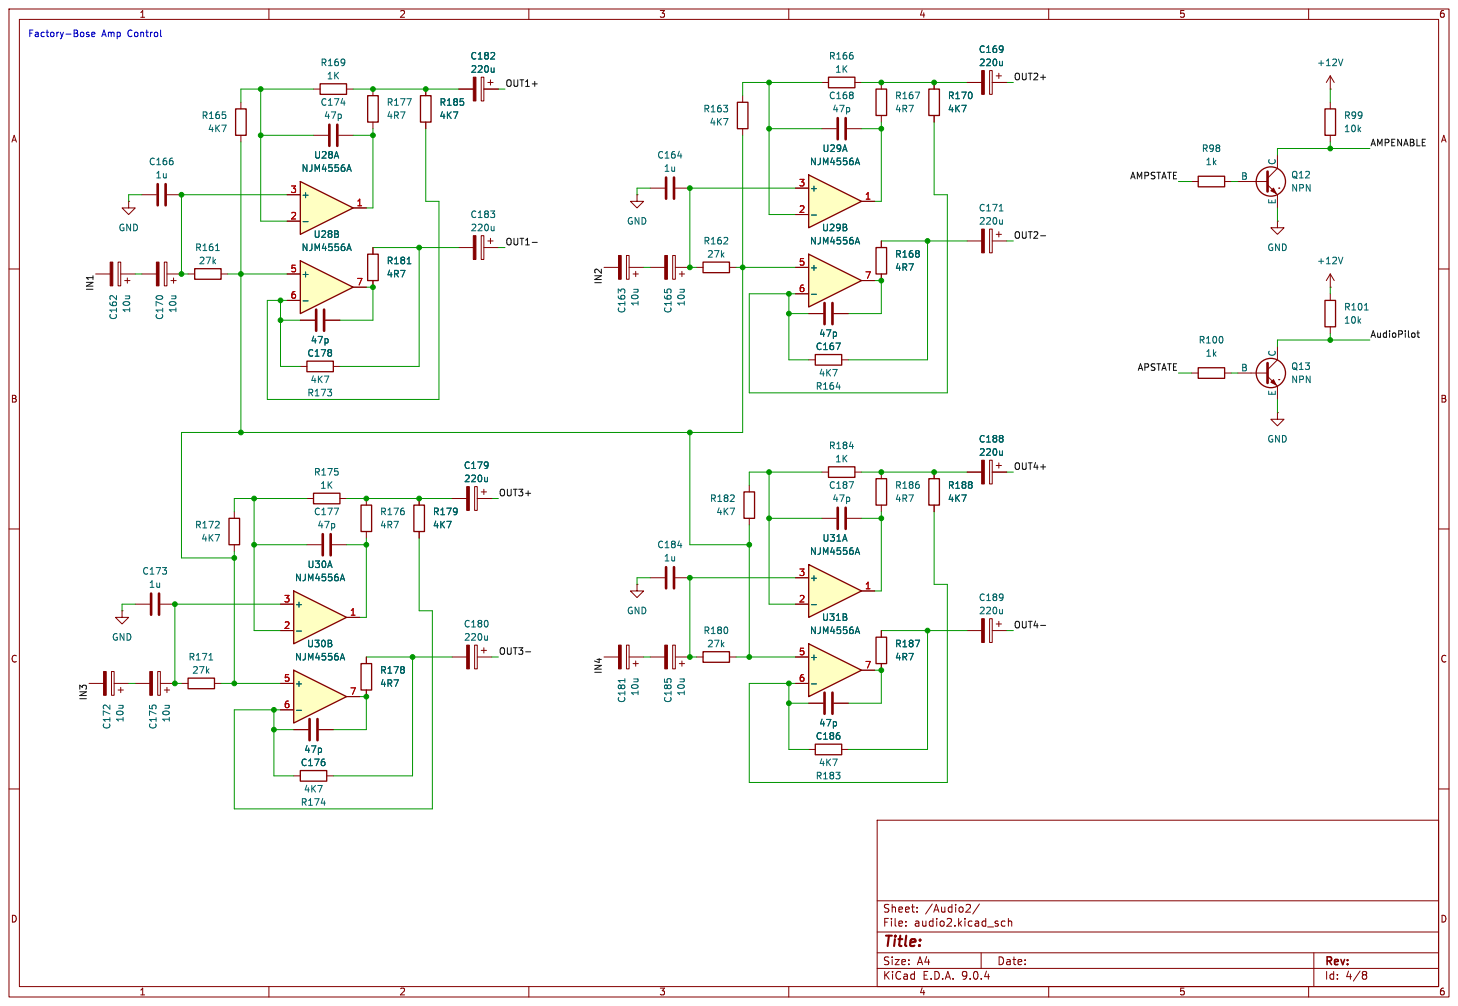
[picture p8: page 1]
