bradport02/RX8-CANbusGateway/PCBs/RX8-8/RX8-8.kicad_pcb

## KiCad design PCBs/RX8-8/RX8-8.kicad_pcb (2026-03-02)

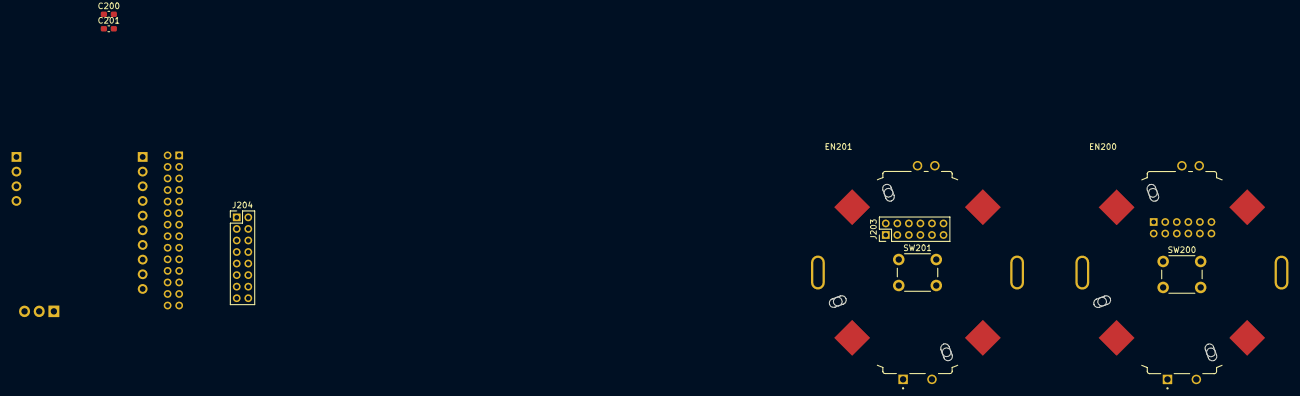
[picture p9: board RX8-8.kicad_pcb from above]

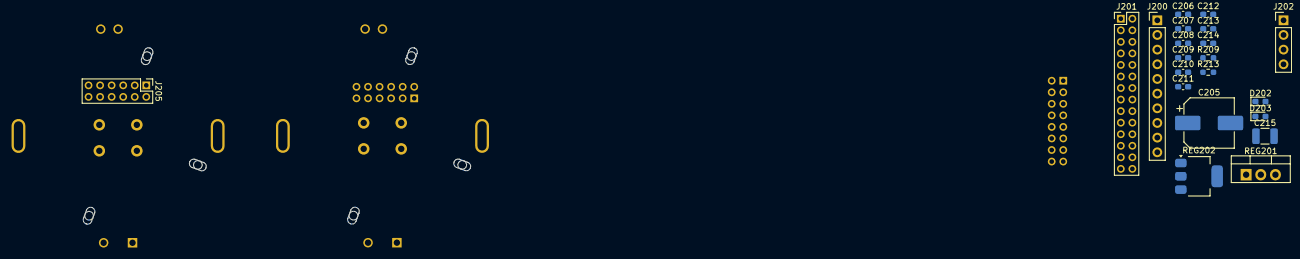
[picture p10: board RX8-8.kicad_pcb from below]

Board: 2 copper layers, 29 parts (21 on the bottom side), 30 nets, no tracks yet.

Parts:
C200, C201, C206, C207, C209, C211, C212, C213: 10n; C_0603_1608Metric_Pad1.08x0.95mm_HandSolder
C205: 47u; CP_Elec_8x10.5
C208, C210, C214: 100n; C_0603_1608Metric_Pad1.08x0.95mm_HandSolder
C215: 10u; C_1210_3225Metric_Pad1.33x2.70mm_HandSolder
D202, D203: LED; LED_0603_1608Metric_Pad1.05x0.95mm_HandSolder
EN200, EN201: PER351-P115-N0010; XDCR_PER351-P115-N0010
J200: OUT_TO_CCU; PinHeader_1x10_P2.54mm_Vertical
J201: Conn_01x24_Pin; PinHeader_2x14_P2.00mm_Vertical
J202: IND; PinHeader_1x04_P2.54mm_Vertical
J203, J205: GC9A01; PinHeader_2x06_P2.00mm_Vertical
J204: GC9A01; PinHeader_2x08_P2.00mm_Vertical
R209: 2K2; R_0603_1608Metric_Pad0.98x0.95mm_HandSolder
R213: 22k; R_0603_1608Metric_Pad0.98x0.95mm_HandSolder
REG201: LM7805_TO220; TO-220-3_Vertical
REG202: LD1117S33TR_SOT223; SOT-223-3_TabPin2
SW200, SW201: SW_Push; SW_PUSH_6mm_H4.3mm

Connections:
+12V: C205.1, C208.1, J201.1, REG201.1 (VI)
/Power and IO/CS1: J201.19, J203.8
/Power and IO/CS2: J201.22, J204.6
/Power and IO/CS3: J201.21, J205.8
/Power and IO/EN1A: C206.1, EN200.A, J201.5
/Power and IO/EN1B: C207.1, EN200.B, J201.6
/Power and IO/EN1C: C209.1, EN200.C, J201.7
/Power and IO/EN2A: C211.1, EN201.A, J201.8
/Power and IO/EN2B: C212.1, EN201.B, J201.9
/Power and IO/EN2C: C213.1, EN201.C, J201.10
/Power and IO/LCD_BACK: J201.27, J202.4, J203.2, J204.2, J205.2
/Power and IO/LCD_DC: J201.23, J203.7, J204.5, J205.7
/Power and IO/LCD_RST1: J201.14, J203.11
/Power and IO/LCD_RST2: J201.15, J204.9
/Power and IO/LCD_RST3: J201.24, J205.11
/Power and IO/MOSI: J201.18, J203.10, J204.8, J205.10
/Power and IO/SCK: J203.9, J204.7, J205.9
/Power and IO/SCL: J201.4, J204.14
/Power and IO/SDA: J201.3, J204.15
/Power and IO/SW1: C200.1, J201.11, SW200.1
/Power and IO/SW2: C201.1, J201.12, SW201.1
/Power and IO/TP_INT: J201.17, J204.13
/Power and IO/TP_RST: J201.16, J204.12
GND: C200.2, C201.2, C205.2, C208.2, C210.2, C211.2, C212.2, C213.2, C214.2, C215.2, EN200.D, EN200.SH1 (SHIELD), EN200.SH2 (SHIELD), EN200.SH3 (SHIELD), EN200.SH4 (SHIELD), EN200.SH5 (SHIELD), EN200.SH6 (SHIELD), EN201.D, EN201.SH1 (SHIELD), EN201.SH2 (SHIELD), EN201.SH3 (SHIELD), EN201.SH4 (SHIELD), EN201.SH5 (SHIELD), EN201.SH6 (SHIELD), R209.1, R213.2, REG201.2 (GND), REG202.1 (GND), SW200.2, SW201.2
unnamed: C206.2, C207.2, C209.2
unnamed: D202.1 (K), R209.2
unnamed: D203.1 (K), R213.1
P3V3: C215.1, D203.2 (A), J205.4, REG202.2 (VO)
P5V: C210.1, C214.1, D202.2 (A), J203.4, J204.4, J204.10, REG201.3 (VO), REG202.3 (VI)
PGND: J201.2, J203.1, J203.5, J203.6, J203.12, J204.1, J204.11, J205.1, J205.5, J205.6, J205.12
