bradport02/RX8-CANbusGateway/PCBs/RX8-7/RX8-7(STM_CENTRE).kicad_pcb

## KiCad design PCBs/RX8-7/RX8-7(STM_CENTRE).kicad_pcb (2026-03-02)

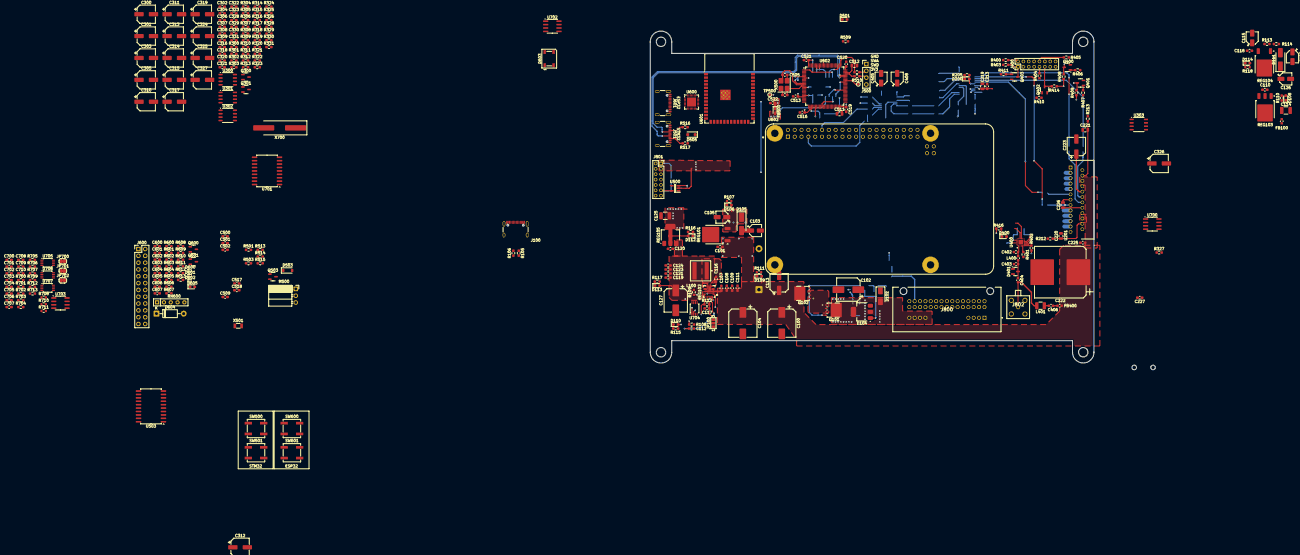
[picture p11: board RX8-7(STM_CENTRE).kicad_pcb from above]

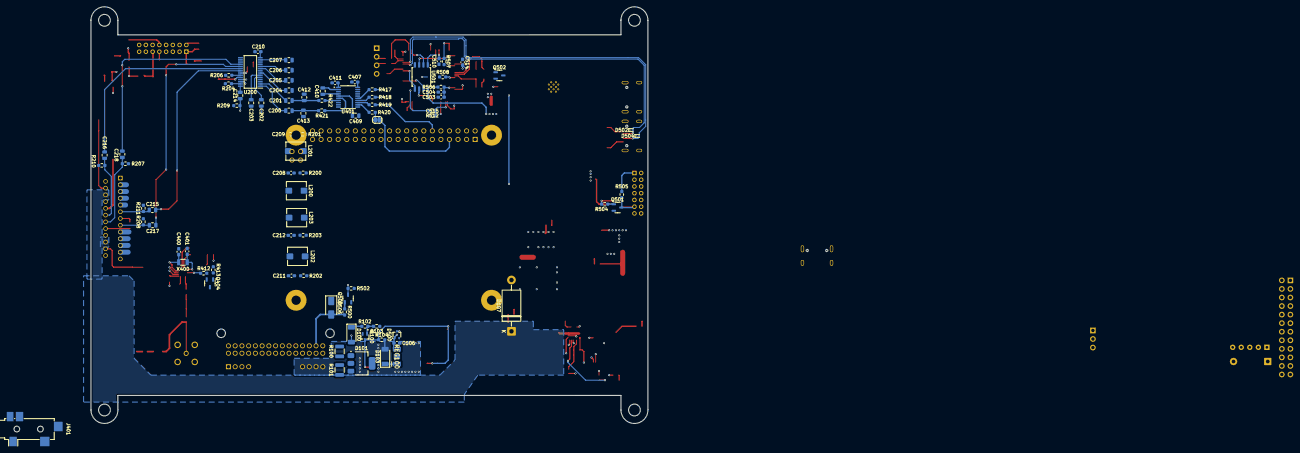
[picture p12: board RX8-7(STM_CENTRE).kicad_pcb from below]

Board: 4 copper layers, 165.3 x 123.7 mm, 387 parts (88 on the bottom side), 302 nets.

Parts:
C100: 100u; CP_Elec_10x10
C101, C106, C109, C110, C111, C116, C118, C120, C208, C209, C211, C212, C213, C225, C227, C328, C329, C330, C331, C407, C411, C500, C501, C502, C503, C509, C510, C513, C514, C515, C516, C519, C520, C521, C601, C602, C604, C605, C606, C700, C703, C704, C705, C706, C707, C708, C709, C710: 100n; C_0603_1608Metric_Pad1.08x0.95mm_HandSolder
C102: 10u; CP_Elec_8x10.5
C103, C115, C122, C405, C408: 10u; CP_Elec_4x5.4
C104: 220u; CP_Elec_10x10
C105: 1u; CP_Elec_4x5.7
C107, C108, C504, C522, C607: 10u; C_0603_1608Metric_Pad1.08x0.95mm_HandSolder
C112: 22n; C_0603_1608Metric_Pad1.08x0.95mm_HandSolder
C113, C223: 47u; CP_Elec_6.3x5.9
C114, C125: 10u; C_1210_3225Metric_Pad1.33x2.70mm_HandSolder
C117: 4.7u; C_0603_1608Metric_Pad1.08x0.95mm_HandSolder
C119, C121: 47u; C_0603_1608Metric_Pad1.08x0.95mm_HandSolder
C123: 22u; C_0603_1608Metric_Pad1.08x0.95mm_HandSolder
C124: 22uF; C_0603_1608Metric_Pad1.08x0.95mm_HandSolder
C126: 1u; CP_Elec_4x5.4
C127: 470u; CP_Elec_8x10.5
C200, C201, C202, C203, C204, C205, C206, C207, C214, C220, C221: 1u; C_0805_2012Metric
C210: 470n; C_0603_1608Metric_Pad1.08x0.95mm_HandSolder
C215, C216, C217, C218, C409, C410, C412, C413, C511, C512: 2u2; C_0805_2012Metric
C219: 10u; C_0805_2012Metric
C222: 4700u; CP_Elec_18x22
C226: 470n; C_0805_2012Metric
C300, C301, C303, C305, C314, C315, C317, C319: 10u; CP_Elec_6.3x7.7
C302, C304, C316, C318, C600, C603: 1u; C_0603_1608Metric_Pad1.08x0.95mm_HandSolder
C306, C307, C308, C309, C320, C321, C322, C323: 47p; C_0603_1608Metric_Pad1.08x0.95mm_HandSolder
C310, C311, C312, C313, C324, C325, C326, C327: 220u; CP_Elec_6.3x7.7
C400, C401, C701, C702: 22p; C_0603_1608Metric_Pad1.08x0.95mm_HandSolder
C402, C403: NA; C_0603_1608Metric
C404: 470p; C_0603_1608Metric
C406: 10u; C_0603_1608Metric
C505, C508: 12p; C_0603_1608Metric_Pad1.08x0.95mm_HandSolder
C517, C518: 15p; C_0603_1608Metric_Pad1.08x0.95mm_HandSolder
D100, D103: 1N5402; D_SOD-128
D101, D104: D_Zener; SOT-223-3_TabPin2
D102, D506: SMAJ24A; D_SMA
D105, D111: 1N4007; D_SMA_Handsoldering
D106, D108, D109, D110, D112, D113, D114, D200, D400, D501, D605: LED; LED_0603_1608Metric_Pad1.05x0.95mm_HandSolder
D107: 1.5KExxA; D_DO-201AE_P15.24mm_Horizontal
D401: NUP2105L; SOT-23
D500: BAT54W; SOT-323_SC-70
D502, D504, D600, D601, D602: ESD9B5.0ST5G; D_SOD-923
D503: 1N4001; D_SOD-123
D505: 1N5819; D_SOD-123F
D603: WS2812B; LED_WS2812B_PLCC4_5.0x5.0mm_P3.2mm
D604: 1N5819; D_DO-41_SOD81_P10.16mm_Horizontal
FB100, FB400: FerriteBead; C_0603_1608Metric
FB500: FerriteBead; LED_0603_1608Metric_Pad1.05x0.95mm_HandSolder
J100, J501, J601: USB_C_Receptacle_USB2.0_16P; USB_C_Receptacle_GCT_USB4105-xx-A_16P_TopMnt_Horizontal
J400: Conn_01x15_Pin; PinHeader_2x08_P2.00mm_Vertical
J401: AudioJack3_Ground; Jack_3.5mm_CUI_SJ2-3593D-SMT_Horizontal
J500: Conn_01x04_Pin; PinHeader_1x04_P2.54mm_Vertical
J600: Conn_01x24_Pin; PinHeader_2x12_P2.54mm_Vertical
J800: 34958-0383; 349580383
J801: Conn_01x12_Pin; PinSocket_2x07_P2.00mm_Vertical
J802: 59S10H-400T5-A; 59S10H400T5A
JP100: Jumper_3_Bridged12; SolderJumper-3_P1.3mm_Open_Pad1.0x1.5mm_NumberLabels
JP600: Jumper_2_Open; SolderJumper-2_P1.3mm_Open_RoundedPad1.0x1.5mm
JP700, JP701, JP702: Jumper_2_Bridged; SolderJumper-2_P1.3mm_Open_RoundedPad1.0x1.5mm
L100: 4.7uH; XAL7030472MEC
L200, L201, L202, L203: 10u; L_Bourns_SRP5030T
L400: NA; C_0603_1608Metric
L401: 10u; L_1210_3225Metric
M500: Fan_3pin; PinSocket_1x03_P2.54mm_Horizontal
Q100: NPN; SOT65P210X125-3N
Q101, Q102: SQJ407EP-T1_GE3; PowerPAK-SO-8L_Option-2_VIS
Q300, Q301: NPN; SOT-23-3
Q400, Q401, Q402, Q403, Q404, Q500, Q501, Q502, Q503, Q600, Q601: NPN; SOT-23-3(CORRECTED)
R100, R101: 10k; R_1210_3225Metric
R102, R110, R116, R205, R416, R613: 22k; R_0603_1608Metric_Pad0.98x0.95mm_HandSolder
R103, R104, R206, R207, R208, R210, R211, R213, R330, R331, R400, R401, R402, R403, R404, R405, R408, R409, R413, R414, R417, R418, R419, R420, R500, R501, R502, R503, R504, R505, R508, R509, R514, R600, R601, R609, R610, R702, R707, R709, R712, R713: 10k; R_0603_1608Metric_Pad0.98x0.95mm_HandSolder
R105, R106, R516, R517, R604, R605: 5k1; R_0603_1608Metric_Pad0.98x0.95mm_HandSolder
R107, R111, R118: 22k; R_0603_1608Metric
R108: 62k; R_0603_1608Metric_Pad0.98x0.95mm_HandSolder
R109: 51k; R_0603_1608Metric_Pad0.98x0.95mm_HandSolder
R112, R204, R209: 100k; R_0603_1608Metric_Pad0.98x0.95mm_HandSolder
R113: 240R; R_0603_1608Metric_Pad0.98x0.95mm_HandSolder
R114: 1k5; R_0603_1608Metric_Pad0.98x0.95mm_HandSolder
R115, R117: 2K2; R_0603_1608Metric_Pad0.98x0.95mm_HandSolder
R200, R201, R202, R203: 10R; R_0603_1608Metric_Pad0.98x0.95mm_HandSolder
R212, R603: 47k; R_0603_1608Metric_Pad0.98x0.95mm_HandSolder
R300, R301, R314, R315: 27k; R_0603_1608Metric_Pad0.98x0.95mm_HandSolder
R302, R303, R304, R305, R312, R313, R316, R317, R318, R319, R326, R327: 4K7; R_0603_1608Metric_Pad0.98x0.95mm_HandSolder
R306, R307, R320, R321: 1K; R_0603_1608Metric_Pad0.98x0.95mm_HandSolder
R308, R309, R310, R311, R322, R323, R324, R325: 4R7; R_0603_1608Metric_Pad0.98x0.95mm_HandSolder
R328, R329, R406, R407, R410, R411, R412, R512, R515, R608: 1k; R_0603_1608Metric_Pad0.98x0.95mm_HandSolder
R421, R422: 470R; R_0603_1608Metric_Pad0.98x0.95mm_HandSolder
R506, R507, R606, R607, R611, R612, R700, R703, R704: 0R; R_0603_1608Metric_Pad0.98x0.95mm_HandSolder
R510, R511: 22R; R_0603_1608Metric_Pad0.98x0.95mm_HandSolder
R513: 82k; R_0603_1608Metric_Pad0.98x0.95mm_HandSolder
R602: 22k1; R_0603_1608Metric_Pad0.98x0.95mm_HandSolder
R701, R705, R706: 120R; R_0603_1608Metric_Pad0.98x0.95mm_HandSolder
R708, R710, R711: 10k; R_0603_1608Metric
REG100: TPS7B8233QDGNRQ1; SOP65P490X110-9N
REG101: LF80_TO252; TO-252-2
REG102: MPQ4317GRE-5-AEC1-P; QFN-20_MPQ4317_MNP
REG103: NCV1117DT33T5G; TO-252-3_TabPin2
REG104: NCV317MBDTRKG; TO-252-2
REG105: LD1117S33TR_SOT223; SOT-223-3_TabPin2
RN600: R_Network04; R_Array_SIP5
SW500, SW501, SW600, SW601: SW_Push; SW_SPST_B3SL-1002P
TP500, TP501: TestPoint; TestPoint_Pad_D1.0mm
U200: TDA7719; SOP65P640X120-28N
U201: TDA7388; TO100P465X2910X1977-25P
U300, U301, U302, U303: NJM4556A; SSOP-8_3.9x5.05mm_P1.27mm
U400: SI4703-C19-GM; SI4703C19GM
U401: PCM5102A; TSSOP-20_4.4x6.5mm_P0.65mm
U500: MCP1402T-E_OT; SOT95P270X145-5N
U501: W25Q32JVSS; SOIC-8_5.3x5.3mm_P1.27mm
U502: STM32H750VBTx; LQFP-100_14x14mm_P0.5mm
U503: 74HC245; SOIC-20W_7.5x12.8mm_P1.27mm
U600: CP2102N-Axx-xQFN28; QFN-28-1EP_5x5mm_P0.5mm_EP3.35x3.35mm
U601: ESP32-S3-WROOM-1
U602: Raspberry_Pi_5; MODULE_RASPBERRY_PI_4B_4GB
U700, U702, U703: MCP2551-I-SN; SOIC-8_3.9x4.9mm_P1.27mm
U701: MCP2515-xSO; SOIC-18W_7.5x11.6mm_P1.27mm
U704, U705, U706, U707: LM75B; TSSOP-8_3x3mm_P0.65mm
X400, X501: 32.768K; Crystal_SMD_3215-2Pin_3.2x1.5mm
X500: 25MHz; Crystal_SMD_3225-4Pin_3.2x2.5mm_HandSoldering
X700: 8MHz; Crystal_SMD_HC49-SD_HandSoldering

Connections:
3P3: C408.1, C411.1, D400.2 (A), FB100.1, R402.2, R413.2, U400.10 (VIO), U400.11 (VD), U400.16 (VA), U401.1 (CPVDD), U401.8 (AVDD)
8P5: C110.1, C126.1, C213.1, C219.1, C328.2, C329.2, C330.2, C331.2, D111.1 (K), D114.2 (A), R113.1, REG103.3 (VI), REG104.2 (VOUT), U200.24 (VDD), U300.8 (V+), U301.8 (V+), U302.8 (V+), U303.8 (V+)
+12V: C100.1, C101.1, C104.1, C107.1, C108.1, C109.1, C111.1, C113.1, C115.1, C118.1, C222.1, C225.1, D107.1 (A1), D109.2 (A), D503.1 (K), FB400.1, J400.3, J400.4, J600.1, J600.2, M500.2 (+), Q102.5 (D), R330.2, R331.2, R408.2, R409.2, R414.2, REG101.1 (VI), REG102.3 (VIN), REG102.12 (VIN), REG104.3 (VIN), U201.6 (VCC_1), U201.20 (VCC_2)
+BAT: D102.2 (A2), D103.2 (A), D104.2 (A), J800.5, J800.6, J800.7, J800.8, Q101.5 (D), R104.2
/AMPENABLE: J800.28, Q300.1 (C), R330.1
/ANT_IN: C404.2, J802.1, L401.1
/Audio2/APSTATE: R329.1, U601.18 (IO10)
/Audio3/CDBUS+: R411.1, U601.17 (IO9)
/Audio3/CDEJECT: R410.1, U601.12 (IO8)
/Audio3/CDMUTE: R406.1, U601.6 (IO6)
/Audio3/CD_ENABLE: R407.1, U601.7 (IO7)
/Audio3/FMGPIO1: R412.1, U400.19 (GPIO1)
/Audio3/I2S_BCLK: R419.1, U602.12 (GPIO18/SPI1_~CE0/PCM_CLK/PWM0)
/Audio3/I2S_DOUT: R418.1, U602.40 (GPIO21/SPI1_SCLK/PCM_DOUT)
/Audio3/I2S_LRCLK: R417.1, U602.35 (GPIO19/SPI1_MISO/PCM_FS)
/Audio3/I2S_SCLK: JP600.2 (B), R420.1
/Audio3/MediaBUS+: J400.1, Q403.1 (C), R403.1
/Audio3/MediaBUS-: J400.2, R400.2
/Audio3/MediaCLK: J400.9, R404.1
/Audio3/MediaDO: J400.10, R405.1
/Audio3/MediaEJECT: J400.7, Q401.1 (C), R409.1
/Audio3/MediaENABLE: J400.11, Q402.1 (C), R414.1
/Audio3/MediaMUTE: J400.12, Q400.1 (C), R408.1
/Audio3/RF_IN: C402.2, L400.1, U400.2 (FMIP)
/Audio3/Tuner_RST: R401.2, U400.5 (~RST), U601.4 (IO4)
/Audio/AMP_MUTE: R206.2, R212.1, U601.20 (IO12)
/Audio/AUXIN_L: C206.1, J401.T
/Audio/AUXIN_R: C207.1, J401.R
/Audio/BEEP_OUT: C214.2, R209.1, R512.2
/Audio/CDIN_L: C202.1, J400.15
/Audio/CDIN_R: C203.1, J400.13
/Audio/DAC_OUTL: C200.1, C413.2, R421.2
/Audio/DAC_OUTR: C201.1, C412.2, R422.2
/Audio/FMOUT_L: C204.1, U400.14 (LOUT)
/Audio/FMOUT_R: C205.1, U400.13 (ROUT)
/Audio/IN1: C215.2, C301.2, R211.1, U201.11 (IN1)
/Audio/IN2: C216.2, C300.2, R210.1, U201.12 (IN2)
/Audio/IN3: C217.2, C315.2, R208.1, U201.15 (IN3)
/Audio/IN4: C218.2, C314.2, R207.1, U201.14 (IN4)
/Audio/LMOUT: R204.2, U502.30 (PA6)
/Audio/OUT1+: C312.1, L200.1, U201.9 (OUT1+)
/Audio/OUT1-: C208.2, C313.1, J800.27, U201.7 (OUT1-)
/Audio/OUT2+: C310.1, L201.1, U201.5 (OUT2+)
/Audio/OUT2-: C209.2, C311.1, J800.12, U201.3 (OUT2-)
/Audio/OUT3+: C326.1, L203.1, U201.17 (OUT3+)
/Audio/OUT3-: C212.2, C327.1, J800.10, U201.19 (OUT3-)
/Audio/OUT4+: C324.1, L202.1, U201.21 (OUT4+)
/Audio/OUT4-: C211.2, C325.1, J800.25, U201.23 (OUT4-)
/Audio/OUT_FL+: J800.26, L200.2, R200.1
/Audio/OUT_FR+: J800.24, L202.2, R202.1
/Audio/OUT_RL+: J800.11, L201.2, R201.1
/Audio/OUT_RR+: J800.9, L203.2, R203.1
/AudioPilot: J800.13, Q301.1 (C), R331.1
/CAN1H: J800.20, JP700.1 (A), U700.7 (CANH)
/CAN1L: J800.21, R701.1, U700.6 (CANL)
/CAN2H: J800.22, R705.1, R706.1, U702.7 (CANH), U703.7 (CANH)
/CAN2L: J800.23, JP701.1 (A), JP702.1 (A), U702.6 (CANL), U703.6 (CANL)
/Connectors/Illumination+: D506.2 (A2), J800.37, R500.1
/Connectors/LCD_AC: J801.4, U503.15 (B3)
/Connectors/LCD_BACKLIGHT: J801.11, Q501.1 (C), R505.1, U500.5 (OUT)
/Connectors/LCD_CS: J801.5, U503.18 (B0)
/Connectors/LCD_EN: J801.9, U503.13 (B5)
/Connectors/LCD_MOSI: J801.7, U503.16 (B2)
/Connectors/LCD_RS: J801.3, U503.14 (B4)
/Connectors/LCD_SCK: J801.6, U503.17 (B1)
/LED_DOUT: D603.2 (DOUT), J800.32
/MCU1/BOOT0: C501.1, C510.2, R501.2, SW501.2, U502.94 (BOOT0)
/MCU1/Backlight_PWM: R504.1, U500.3 (IN), U502.89 (PB3)
/MCU1/CAN1_RXD: U502.81 (PD0), U700.4 (RXD)
/MCU1/CAN1_TXD: U502.82 (PD1), U700.1 (TXD)
/MCU1/CAN2_RXD: U502.52 (PB13), U703.4 (RXD)
/MCU1/CAN2_TXD: U502.51 (PB12), U703.1 (TXD)
/MCU1/CCU_RX: J600.4, U503.11 (B7)
/MCU1/CCU_TX: J600.3, U503.12 (B6)
/MCU1/ESP32_RX: U502.22 (PA0), U601.10 (IO17)
/MCU1/ESP32_TX: U502.23 (PA1), U601.11 (IO18)
/MCU1/FAN_TACHO: R513.2, R514.1, U502.59 (PD12)
/MCU1/Illum_IN: Q500.1 (C), R502.1, U502.31 (PA7)
/MCU1/MT1_UH: J600.7, U502.39 (PE9)
/MCU1/MT1_UL: J600.8, U502.38 (PE8)
/MCU1/MT1_VH: J600.9, U502.41 (PE11)
/MCU1/MT1_VL: J600.10, U502.40 (PE10)
/MCU1/MT1_WH: J600.11, U502.43 (PE13)
/MCU1/MT1_WL: J600.12, U502.42 (PE12)
/MCU1/MT2_UH: J600.13, U502.63 (PC6)
/MCU1/MT2_UL: J600.14, U502.29 (PA5)
/MCU1/MT2_VH: J600.15, U502.64 (PC7)
/MCU1/MT2_VL: J600.16, U502.34 (PB0)
/MCU1/MT2_WH: J600.17, U502.65 (PC8)
/MCU1/MT2_WL: J600.18, U502.35 (PB1)
/MCU1/NRST: R503.2, R508.2, U502.14 (NRST)
/MCU1/OUT1Hz: Q502.2 (B), TP500.1, U502.7 (PC13)
/MCU1/OUT25MHz: TP501.1, U502.67 (PA8)
/MCU1/QSPI_CLK: U501.6 (CLK), U502.36 (PB2)
/MCU1/QSPI_CS: U501.1 (~CS), U502.92 (PB6)
/MCU1/QSPI_D0: U501.5 (DI/IO_{0}), U502.66 (PC9)
/MCU1/QSPI_D1: U501.2 (DO/IO_{1}), U502.78 (PC10)
/MCU1/QSPI_D2: U501.3 (~WP/IO_{2}), U502.1 (PE2)
/MCU1/QSPI_D3: U501.7 (~HOLD/~RESET/IO_{3}), U502.60 (PD13)
/MCU1/STM32_RX: U502.83 (PD2), U602.8 (GPIO14/UART_TXD)
/MCU1/STM32_TX: U502.80 (PC12), U602.10 (GPIO15/UART_RXD)
/MCU1/U1LCD_CS: U502.15 (PC0), U503.2 (A0)
/MCU1/U1LCD_MOSI: U502.16 (PC1), U503.4 (A2)
/MCU1/U1LCD_SCK: U502.46 (PB10), U503.3 (A1)
/MCU1/UART7_RX: U502.37 (PE7), U503.9 (A7)
/MCU1/UART7_TX: U502.77 (PA15), U503.8 (A6)
/MCU1/USB_CC1: J501.A5 (CC1), R516.1
/MCU1/USB_CC2: J501.B5 (CC2), R517.1
/MCU1/USB_DN: D502.2 (A2), J501.A7 (D-), J501.B7 (D-), U502.70 (PA11)
/MCU1/USB_DP: D504.2 (A2), J501.A6 (D+), J501.B6 (D+), U502.71 (PA12)
/MCU2/CS1: J600.21, U601.32 (IO39)
/MCU2/CS2: J600.22, U601.33 (IO40)
/MCU2/CS3: J600.23, U601.9 (IO16)
/MCU2/LED_DOUT: D603.4 (DIN), U601.5 (IO5), U601.8 (IO15)
/MCU2/PI_CS: U602.24 (~CE0_SPI0/GPIO08), U701.16 (~CS)
/MCU2/PI_INT: U602.22 (GPIO25/SDIO_DAT1), U701.12 (~INT)
/MCU2/PI_MISO: U602.21 (MISO_SPI0/GPIO09), U701.15 (SO)
/MCU2/PI_MOSI: U602.19 (MOSI_SPI0/GPIO10), U701.14 (SI)
/MCU2/PI_SCLK: U602.23 (SCLK_SPI0/GPIO11), U701.13 (SCK)
/MCU2/Pi_SCL: RN600.4 (R3), U602.28 (ID_SC_I2C0/GPIO01)
/MCU2/Pi_SDA: RN600.5 (R4), U602.27 (ID_SD_I2C0/GPIO00)
/MCU2/U6DTR: Q601.3 (E), R600.1, U600.28 (~DTR)
/MCU2/U6RTS: Q600.3 (E), R601.1, U600.24 (~RTS)
/MCU2/U6RXD: R611.2, U601.36 (RXD0)
/MCU2/U6TXD: R612.2, U601.37 (TXD0)
/MCU2/U6_EN: C601.2, C603.1, R606.2, R609.2, SW600.2, U601.3 (EN)
/MCU2/U6_GPIO0: C602.2, R607.1, SW601.2, U601.27 (IO0)
/MCU2/U6_MISO: J600.24, U601.34 (IO41)
/MCU2/USB2_CC1: J601.A5 (CC1), R604.1
/MCU2/USB2_CC2: J601.B5 (CC2), R605.1
/MCU2/USB2_D+: D602.2 (A2), J601.A6 (D+), J601.B6 (D+), U600.4 (D+)
/MCU2/USB2_D-: D601.2 (A2), J601.A7 (D-), J601.B7 (D-), U600.5 (D-)
/Power/ENABLE: D100.2 (A), D101.1 (K), R100.2, R101.2, REG102.9 (EN)
/Power/PG_OUT: D110.2 (A), R112.1, REG102.14 (PG)
/SCL: J600.5, RN600.3 (R2), U200.26 (SDA), U400.8 (SDIO), U502.96 (PB9), U601.39 (IO1), U704.2 (SCL), U705.2 (SCL), U706.2 (SCL), U707.2 (SCL)
/SDA: J600.6, RN600.2 (R1), U200.25 (SCL), U400.7 (SCLK), U502.95 (PB8), U601.38 (IO2), U704.1 (SDA), U705.1 (SDA), U706.1 (SDA), U707.1 (SDA)
/Sensors/T_SD: R707.1, R708.1, R710.1, R711.1, U704.3 (O.S.), U705.3 (O.S.), U706.3 (O.S.), U707.3 (O.S.)
ACC: J800.38, R100.1
AGND: C100.2, C101.2, C102.2, C103.2, C104.2, C105.2, C106.2, C107.2, C108.2, C109.2, C110.2, C111.2, C112.2, C113.2, C114.2, C115.2, C117.2, C118.2, C119.2, C120.2, C121.2, C122.2, C123.2, C124.2, C125.2, C126.2, C127.2, C210.2, C213.2, C219.2, C220.2, C221.2, C222.2, C223.2, C225.2, C226.2, C227.2, C302.1, C304.1, C316.1, C318.1, C328.1, C329.1, C330.1, C331.1, C400.2, C401.2, C402.1, C403.1, C405.2, C407.2, C408.2, C409.1, C411.2, C412.1, C413.1, C500.2, C501.2, C502.2, C503.2, C504.2, C505.1, C508.2, C509.1, C510.1, C511.2, C512.2, C513.1, C514.1, C515.1, C516.1, C517.2, C518.2, C519.1, C520.1, C521.1, C522.2, C600.2, C601.1, C602.1, C603.2, C604.2, C605.2, C606.2, C607.2, C700.1, C701.1, C702.1, C703.1, C704.1, C705.1, C706.1, C707.1, C708.1, C709.1, C710.1, D101.2 (A), D102.1 (A1), D107.2 (A2), D401.1 (A1), D502.1 (A1), D504.1 (A1), D506.1 (A1), D600.1 (A1), D601.1 (A1), D602.1 (A1), D603.3 (VSS), J100.A1 (GND), J100.A12 (GND), J100.B1 (GND), J100.B12 (GND), J100.S1 (SHIELD), J400.5, J400.6, J400.14, J401.S, J500.1, J501.A1 (GND), J501.A12 (GND), J501.B1 (GND), J501.B12 (GND), J501.S1 (SHIELD), J601.A1 (GND), J601.A12 (GND), J601.B1 (GND), J601.B12 (GND), J601.S1 (SHIELD), J800.1, J800.2, J800.3, J800.4, J801.8, J801.10, J801.12, J802.2, J802.3, J802.4, J802.5, JP100.1 (A), Q100.3 (E), Q300.3 (E), Q301.3 (E), Q400.3 (E), Q401.3 (E), Q402.3 (E), Q403.3 (E), Q404.3 (E), Q500.3 (E), Q501.3 (E), Q502.3 (E), Q503.3 (E), R101.1, R103.1, R105.2, R106.2, R107.1, R108.2, R109.2, R110.2, R111.1, R114.2, R115.1, R116.2, R117.1, R118.1, R205.2, R207.2, R208.2, R209.2, R210.2, R211.2, R400.1, R401.1, R507.1, R508.1, R514.2, R516.2, R517.2, R603.1, R604.2, R605.2, R610.2, R613.1, R700.2, R703.2, R704.2, REG100.4 (GND), REG100.5 (GND), REG100.6 (GND), REG100.9 (EP), REG101.2 (GND), REG102.4 (PGND), REG102.5 (PGND), REG102.10 (PGND), REG102.11 (PGND), REG102.17 (AGND), REG103.1 (GND), REG105.1 (GND), SW501.1, SW600.1, SW601.1, U200.3 (QD1G), U200.4 (QD2G), U200.8 (QD3G), U200.11 (FDL-/QD4G), U200.12 (FDR+/QD4G), U200.15 (GND), U201.1 (TAB), U201.2 (P-GND2), U201.8 (P-GND1), U201.13 (S-GND), U201.18 (P-GND3), U201.24 (P-GND4), U300.4 (V-), U301.4 (V-), U302.4 (V-), U303.4 (V-), U400.3 (RFGND), U400.4 (GND), U400.12 (GND), U400.15 (GND), U400.21 (GND), U401.3 (CPGND), U401.9 (AGND), U401.10 (DEMP), U401.11 (FLT), U401.16 (FMT), U401.17 (XSMT), U401.19 (DGND), U500.1 (GND_1), U500.4 (GND_2), U501.4 (GND), U502.10 (VSS), U502.19 (VSSA), U502.26 (VSS), U502.49 (VSS), U502.74 (VSS), U502.99 (VSS), U503.10 (GND), U600.3 (GND), U600.29 (GND), U601.1 (GND), U601.40 (GND), U601.41 (GND), U602.6 (GND), U602.9 (GND), U602.14 (GND), U602.20 (GND), U602.25 (GND), U602.30 (GND), U602.34 (GND), U602.39 (GND), U700.2 (VSS), U701.9 (VSS), U702.2 (VSS), U703.2 (VSS), U704.4 (GND), U704.5 (A2), U704.6 (A1), U704.7 (A0), U705.4 (GND), U705.5 (A2), U705.6 (A1), U706.4 (GND), U706.5 (A2), U706.7 (A0), U707.4 (GND), U707.6 (A1), U707.7 (A0), X500.2, X500.4
AMPSTATE: R213.1, R328.1, U601.21 (IO13)
unnamed: C116.2, L100.1, REG102.7 (SW), REG102.8 (SW)
unnamed: C208.1, R200.2
unnamed: C209.1, R201.2
unnamed: C211.1, R202.2
unnamed: C212.1, R203.2
unnamed: C300.1, C303.2
unnamed: C301.1, C305.2
unnamed: C306.2, R309.2, U300.7
unnamed: C307.2, R311.2, U301.7
unnamed: C308.2, R308.2, U300.1
unnamed: C309.2, R310.2, U301.1
unnamed: C310.2, R306.2, R308.1, R312.2
unnamed: C311.2, R304.2, R309.1
unnamed: C312.2, R307.2, R310.1, R313.2
unnamed: C313.2, R305.2, R311.1
unnamed: C314.1, C317.2
unnamed: C315.1, C319.2
unnamed: C320.2, R323.2, U302.7
unnamed: C321.2, R325.2, U303.7
unnamed: C322.2, R322.2, U302.1
unnamed: C323.2, R324.2, U303.1
unnamed: C324.2, R320.2, R322.1, R326.2
unnamed: C325.2, R318.2, R323.1
unnamed: C326.2, R321.2, R324.1, R327.2
unnamed: C327.2, R319.2, R325.1
unnamed: C406.1, L401.2
unnamed: C406.2, FB400.2
unnamed: C500.1, SW500.1
unnamed: C502.1, R503.1, SW500.2
unnamed: C511.1, U502.48 (VCAP)
unnamed: C512.1, U502.73 (VCAP)
unnamed: D100.1 (K), R102.1
unnamed: C102.1, D103.1 (K), REG100.1 (IN), REG100.2 (EN)
unnamed: D104.1 (K), Q100.1 (C), Q101.4 (G), Q102.4 (G), R104.1
unnamed: C103.1, D105.2 (A)
unnamed: D106.1 (K), R107.2
unnamed: C114.1, D108.2 (A), FB100.2, REG103.2 (VO)
unnamed: D108.1 (K), R110.1
unnamed: D109.1 (K), R111.2
unnamed: D110.1 (K), R115.2
unnamed: C122.1, D111.2 (A), R113.2, R114.1, REG104.1 (ADJUST)
unnamed: D112.1 (K), R116.1
unnamed: D113.1 (K), R117.2
unnamed: D114.1 (K), R118.2
unnamed: D200.2 (A), U200.22 (WIN_TC_/_VREF)
unnamed: D200.1 (K), R205.1
unnamed: D400.1 (K), R416.1
unnamed: C403.2, C404.1, D401.2 (A2), L400.2
unnamed: D501.1 (K), R509.2
unnamed: D503.2 (A), M500.1 (-), Q503.1 (C)
unnamed: D605.2 (A), U602.2 (5V), U602.4 (5V)
unnamed: D605.1 (K), R613.2
unnamed: J100.A5 (CC1), R106.1
unnamed: J100.B5 (CC2), R105.1
unnamed: J500.2, R511.2
unnamed: J500.3, R510.2
unnamed: C117.1, JP100.3 (B), R112.2, REG102.16 (VCC)
unnamed: JP100.2 (C), REG102.1 (MODE)
unnamed: JP600.1 (A), U602.7 (GPCLK0/GPIO04)
unnamed: JP700.2 (B), R701.2
unnamed: JP701.2 (B), R705.2
unnamed: JP702.2 (B), R706.2
unnamed: M500.3 (Tacho), R513.1
unnamed: Q100.2 (B), R102.2, R103.2
unnamed: Q101.1 (S), Q101.2 (S), Q101.3 (S), Q102.1 (S), Q102.2 (S), Q102.3 (S)
unnamed: Q300.2 (B), R328.2
unnamed: Q301.2 (B), R329.2
unnamed: Q400.2 (B), R406.2
unnamed: Q401.2 (B), R407.2
unnamed: Q402.2 (B), R410.2
unnamed: Q403.2 (B), R411.2
unnamed: Q404.2 (B), R412.2
unnamed: Q404.1 (C), R413.1, R416.2
unnamed: Q500.2 (B), R500.2
unnamed: Q501.2 (B), R504.2
unnamed: Q502.1 (C), R509.1
unnamed: Q503.2 (B), R515.2
unnamed: Q600.2 (B), R600.2
unnamed: Q600.1 (C), R606.1
unnamed: Q601.2 (B), R601.2
unnamed: Q601.1 (C), R607.2
unnamed: C116.1, REG102.6 (BST)
unnamed: R108.1, REG102.20 (FREQ)
unnamed: C112.1, REG102.19 (SS)
unnamed: R109.1, REG102.2 (SYNCIN)
unnamed: C210.1, U200.14 (CREF)
unnamed: R204.1, U200.27 (DC_ERR_/_MOUT)
unnamed: C206.2, U200.10 (FDL+/QD4L)
unnamed: C207.2, U200.13 (FDR+/QDAR)
unnamed: R206.1, U200.23 (MUTE)
unnamed: C215.1, U200.21 (OUTLF)
unnamed: C216.1, U200.20 (OUTLR)
unnamed: C218.1, U200.18 (OUTRF)
unnamed: C217.1, U200.19 (OUTRR)
unnamed: C200.2, U200.1 (QD1L)
unnamed: C201.2, U200.2 (QD1R)
unnamed: C202.2, U200.5 (QD2L)
unnamed: C203.2, U200.6 (QD2R)
unnamed: C204.2, U200.7 (QD3L)
unnamed: C205.2, U200.9 (QD3R)
unnamed: C214.1, U200.28 (WIN_IN_/_BEEP)
unnamed: C226.1, C227.1, U201.16 (AC-GND)
unnamed: C220.1, R212.2, U201.22 (MUTE)
unnamed: C221.1, R213.2, U201.4 (ST-BY)
unnamed: C223.1, U201.10 (SVR)
unnamed: C302.2, C303.1, R300.1, U300.3 (+)
unnamed: C308.1, R302.2, R306.1, U300.2 (-)
unnamed: R300.2, R301.2, R302.1, R303.1, R314.2, R315.2, R316.1, R317.1, U300.5 (+), U301.5 (+), U302.5 (+), U303.5 (+)
unnamed: C306.1, R304.1, R312.1, U300.6 (-)
unnamed: C304.2, C305.1, R301.1, U301.3 (+)
unnamed: C309.1, R303.2, R307.1, U301.2 (-)
unnamed: C307.1, R305.1, R313.1, U301.6 (-)
unnamed: C316.2, C317.1, R314.1, U302.3 (+)
unnamed: C322.1, R316.2, R320.1, U302.2 (-)
unnamed: C320.1, R318.1, R326.1, U302.6 (-)
unnamed: C318.2, C319.1, R315.1, U303.3 (+)
unnamed: C323.1, R317.2, R321.1, U303.2 (-)
unnamed: C321.1, R319.1, R327.1, U303.6 (-)
unnamed: C401.1, U400.17 (GPIO3), X400.2
unnamed: C400.1, U400.9 (RCLK), X400.1
unnamed: R402.1, U400.6 (~SEN)
unnamed: R419.2, U401.13 (BCK)
unnamed: C410.1, U401.4 (CAPM)
unnamed: C410.2, U401.2 (CAPP)
unnamed: R418.2, U401.14 (DIN)
unnamed: R417.2, U401.15 (LRCK)
unnamed: R421.1, U401.6 (OUTL)
unnamed: R422.1, U401.7 (OUTR)
unnamed: R420.2, U401.12 (SCK)
unnamed: C409.2, U401.5 (VNEG)
unnamed: C515.2, R512.1, U502.28 (PA4)
unnamed: R510.1, U502.72 (PA13)
unnamed: R511.1, U502.76 (PA14)
unnamed: R515.1, U502.53 (PB14)
unnamed: C517.1, U502.8 (PC14), X501.1
unnamed: C518.1, U502.9 (PC15), X501.2
unnamed: C505.2, U502.12 (PH0), X500.3
unnamed: C508.1, U502.13 (PH1), X500.1
unnamed: C513.2, C514.2, C516.2, C519.2, C520.2, C521.2, C522.1, FB500.1, R506.2, R507.2, U502.11 (VDD), U502.21 (VDDA), U502.27 (VDD), U502.50 (VDD), U502.75 (VDD), U502.100 (VDD)
unnamed: C503.1, C504.1, R506.1, U502.20 (VREF+)
unnamed: R612.1, U600.25 (RXD)
unnamed: R611.1, U600.26 (TXD)
unnamed: C600.1, R602.2, R603.2, U600.8 (VBUS)
unnamed: R608.1, U600.9 (~RST)
unnamed: R610.1, U600.11 (~SUSPEND)
unnamed: R700.1, U700.8 (Rs)
unnamed: C702.2, U701.8 (OSC1), X700.1
unnamed: C701.2, U701.7 (OSC2), X700.2
unnamed: U701.2 (RXCAN), U702.4 (RXD)
unnamed: U701.1 (TXCAN), U702.1 (TXD)
unnamed: R702.1, U701.17 (~RESET)
unnamed: R703.1, U702.8 (Rs)
unnamed: R704.1, U703.8 (Rs)
unnamed: R709.2, U705.7 (A0)
unnamed: R712.2, U706.6 (A1)
unnamed: R713.2, U707.5 (A2)
P3V3: C125.1, C405.1, C407.1, C509.2, C604.1, C605.1, C607.1, C707.2, C708.2, C709.2, C710.2, D112.2 (A), D500.3 (K), D501.2 (A), FB500.2, J500.4, R501.1, R502.2, R608.2, R609.1, R707.2, R708.2, R709.1, R710.2, R711.2, R712.1, R713.1, REG105.2 (VO), RN600.1 (common), U401.20 (DVDD), U501.8 (VCC), U600.6 (VDD), U600.7 (VREGIN), U601.2 (3V3), U704.8 (+Vs), U705.8 (+Vs), U706.8 (+Vs), U707.8 (+Vs)
P5V: C119.1, C120.1, C121.1, C123.1, C124.1, C127.1, C606.1, C700.2, C703.2, C704.2, C705.2, C706.2, D113.2 (A), D505.1 (K), D603.1 (VDD), D604.1 (K), J100.A4 (VBUS), J100.A9 (VBUS), J100.B4 (VBUS), J100.B9 (VBUS), J801.2, L100.2, R403.2, R404.2, R405.2, R702.2, REG102.18 (FB), REG105.3 (VI), U503.1 (A->B), U503.19 (CE), U503.20 (VCC), U700.3 (VDD), U701.18 (VDD), U702.3 (VDD), U703.3 (VDD)
P8V: C105.1, D105.1 (K), D106.2 (A), J801.1, R505.2, REG101.3 (VO), U500.2 (VDD)
VBAT: C106.1, D500.1 (A), REG100.8 (OUT), U502.6 (VBAT)
VBUS: D505.2 (A), J501.A4 (VBUS), J501.A9 (VBUS), J501.B4 (VBUS), J501.B9 (VBUS)
VBUS2: D600.2 (A2), D604.2 (A), J601.A4 (VBUS), J601.A9 (VBUS), J601.B4 (VBUS), J601.B9 (VBUS), R602.1
