bradport02/RX8-CANbusGateway/Application/carplayController.h

#ifndef CARPLAYCONTROLLER_H
#define CARPLAYCONTROLLER_H

#include <QObject>
#include <QProcess>

class CarPlayController : public QObject
{
    Q_OBJECT
public:
    explicit CarPlayController(QObject *parent = nullptr);
    ~CarPlayController();

    Q_INVOKABLE void launchCarPlay();
    Q_INVOKABLE void stopCarPlay();

signals:
    void carplayExited(int exitCode);
    void shouldReturnHome();
    void carplayStarted();   // emitted when process launches successfully
    void carplayStopped();   // emitted when process ends for any reason

private slots:
    void handleProcessFinished(int exitCode, QProcess::ExitStatus exitStatus);
    void handleProcessError(QProcess::ProcessError error);

private:
    QProcess *carplayProcess = nullptr;
};

#endif
