bradport02/RX8-CANbusGateway/(commit log)

2026-03-02 Added PCB V1 Files
    [Audio3.kicad_sch, IO.kicad_sch, MCU.kicad_sch, MCU2.kicad_sch, RX8-7(STM_CENTRE).kicad_pcb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]
2026-03-07 More UART comms, Volume pop up now working.
2026-04-14 STM32 Software Upload
