bradport02/RX8-CANbusGateway/(notices)

Notices in the files:
Embedded Software/STM32/Core/Inc/main.h:
Copyright (c) 2026 STMicroelectronics.
All rights reserved.
This software is licensed under terms that can be found in the LICENSE file
